nguyenhau442001/Bazan_Humanoid/docs/engineering/evolution_reviews/stagnation_review_gen_188.md

# 🔍 Autonomous Stagnation Audit & Bottleneck Review (Generation #188)

*Generated on 2026-11-11 12:25:54 by the Autonomous Evolution Sentinel.*

---

## 📌 Executive Summary
- **Current Champion Policy:** `v13.5_bidirectional_sprint_champion_rev96`
- **Champion Composite HLI-20 Score:** **65.3 / 100.0**
- **Trigger Event:** 10 consecutive evolutionary generations without score improvement.
- **Failed Canonical Motions:** High-Speed Sprint, Backward Walk, Hurdle Obstacle Clearance, Emergency Brake Stop, 10N Push Shock Recovery

---

## 🛑 Top 5 Identified Pain Points & 25 Candidate Solutions

### Pain Point #1: Heading Stability & Directional Drift (P03_yaw_drift)
**Current Score:** `0.55 / 5.00 pts` | **Focus Category:** *Reward Shaping*

> **Diagnosis:** Torso yaw orientation drifts over extended straight-line strides.

**Candidate Solutions Brainstormed (5 Options):**
- A. Double yaw angular velocity penalty weight in upright posture reward
- B. Integrate projected forward heading error in observation clock
- C. Apply phase-synchronized anti-phase hip yaw counter-torque
- D. Enforce asymmetric foot placement feedback to catch yaw deviations
- E. Add micro-damping to the base yaw DOF in physics contact model

👉 **Selected Actionable Fix:** **A. Double yaw angular velocity penalty weight in upright posture reward (p_straight_yaw: -1.2 -> -2.4)**

---

### Pain Point #2: Action Chatter & Joint Jerk (P05_speed_tracking)
**Current Score:** `0.59 / 5.00 pts` | **Focus Category:** *Action Smoothing*

> **Diagnosis:** High-frequency joint target chatter reduces actuator lifespan and smooth motion.

**Candidate Solutions Brainstormed (5 Options):**
- A. Increase EMA low-pass action filter coefficient from 0.60 to 0.72
- B. Increase action rate delta penalty p_action_rate from -0.08 to -0.15
- C. Introduce second-order action acceleration penalty (a_t - 2*a_t-1 + a_t-2)^2
- D. Add weight decay (L2 regularization 1e-4) to final actor linear layer
- E. Cosine-smooth residual reference targets across phase boundaries

👉 **Selected Actionable Fix:** **A & B. Increase EMA action filter from 0.60 to 0.72 and raise p_action_rate to -0.15**

---

### Pain Point #3: High-Impulse Push Recovery (P15_getup_recovery)
**Current Score:** `1.80 / 5.00 pts` | **Focus Category:** *Domain Randomization*

> **Diagnosis:** Fails 10N violent lateral shove due to narrow stance base.

**Candidate Solutions Brainstormed (5 Options):**
- A. Randomize push disturbances during training with magnitudes up to 8.5 N
- B. Train wide-stance capture-point leg spreading triggered by roll acceleration
- C. Add contact normal force sensory feedback into proprioception observation
- D. Modulate knee stiffness dynamically under sudden ground reaction spikes
- E. Deploy adaptive torso counter-lean impulse reflex

👉 **Selected Actionable Fix:** **A. Calibrate domain randomization push range to 1.5 - 8.5 N with adaptive 4-step impulse duration**

---

### Pain Point #4: Forward Velocity Tracking & Reverse Gait (P12_jerk_smoothness)
**Current Score:** `1.56 / 5.00 pts` | **Focus Category:** *Kinematics & Gait*

> **Diagnosis:** Velocity tracking error on extreme sprint (0.5 m/s) and backward steps.

**Candidate Solutions Brainstormed (5 Options):**
- A. Dynamically modulate step cadence down to 0.26s during sprint commands
- B. Add directional linear velocity tracking bonus scaled with command magnitude
- C. Apply velocity-dependent forward torso pitch angle (+0.16 rad at 0.5 m/s)
- D. Scale hip pitch torque saturation limit during high acceleration phases
- E. Use bidirectional speed curriculum with alternating sprint/reverse intervals

👉 **Selected Actionable Fix:** **C. Amplify velocity-dependent torso pitch lean to 0.16 rad at 0.5 m/s sprint**

---

### Pain Point #5: Foot-Ground Impact Shock & Soft Landing (P14_impact_shock)
**Current Score:** `2.25 / 5.00 pts` | **Focus Category:** *Biomechanical Reward*

> **Diagnosis:** Hard heel strike impacts cause ground rebound and transient attitude jitter.

**Candidate Solutions Brainstormed (5 Options):**
- A. Add soft foot touchdown reward penalizing vertical sole contact velocity
- B. Increase nominal swing ground clearance from 10 mm to 18 mm
- C. Apply ankle compliance damping (proportional ankle pitch back-drive)
- D. Enforce smooth knee flexion right before ground strike (pre-touchdown cushioning)
- E. Add rubber sole contact damping in simulation geometry

👉 **Selected Actionable Fix:** **B & D. Increase swing foot clearance reward to 18 mm and add touchdown impact cushioning penalty**

---

## 🚀 5 Targeted Micro-Improvements Applied for Next Evolutionary Cycle

1. **[Reward Shaping]** Doubled straight-line yaw error penalty ($p_{\text{straight\_yaw}} = -2.40$).
2. **[Action Smoothing]** Raised action filter ($\alpha = 0.72$) and action-rate penalty ($p_{\text{rate}} = -0.15$).
3. **[Domain Randomization]** Calibrated kick disturbance range ($1.5 - 8.5\text{ N}$) with multi-step impulse shock.
4. **[Kinematics & Gait]** Amplified forward pitch lean target to $0.16\text{ rad}$ at $0.5\text{ m/s}$ sprint.
5. **[Biomechanical Reward]** Raised swing clearance target to $18\text{ mm}$ and added touchdown cushioning penalty.

*These 5 micro-improvements are automatically injected into the active training environment configuration.*
