nguyenhau442001/Bazan_Humanoid/software/firmware/stm32f411/Drivers/VERSIONS.md

# Vendored sources

Written by `tools/fetch_drivers.py`; do not edit by hand.

| Source | Tag | Commit |
| --- | --- | --- |
| [STMicroelectronics/stm32f4xx-hal-driver](https://github.com/STMicroelectronics/stm32f4xx-hal-driver) | v1.8.6 | `6ef30cf0ef6cc29ad518f37b9e6de89b6b815f90` |
| [STMicroelectronics/cmsis-device-f4](https://github.com/STMicroelectronics/cmsis-device-f4) | v2.6.9 | `3b64b7b0b546cefe84f13c65508126eea58b97d8` |
| [ARM-software/CMSIS_5](https://github.com/ARM-software/CMSIS_5) | 5.9.0 | `2b7495b8535bdcb306dac29b9ded4cfb679d7e5c` |
| [FreeRTOS/FreeRTOS-Kernel](https://github.com/FreeRTOS/FreeRTOS-Kernel) | V11.1.0 | `dbf70559b27d39c1fdb68dfb9a32140b6a6777a0` |
