nguyenhau442001/Bazan_Humanoid/docs/mechanical/bazan_v4_lap_rap.html

# Bazan v4 · Whole-Robot Assembly Manual

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

tổng thể

## 1. Key Dimensions

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

## 2. Design Rules (Easy Motor and Board Swaps)

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

thân

## 3. Fits and Tolerances (All Parts)

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

## 4. Bill of Materials (Whole Robot)

### 4.1 Servos

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

### 4.2 Screws, Inserts, Bearings, Standoffs (Both Legs Included)

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

### 4.3 Boards and Modules (MEASURE Before Printing Sleds)

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

### 4.4 Printed Parts

Mã | File | Tên | SL | Vật liệu | Khối lượng đặc (g) | Hướng in | Bản vẽ
P0 | L_pelvis_plate | Pelvis Plate (Deck 0) | 1 | PLA | 52.5 | mặt dưới úp xuống bàn; tường pin hướng lên | bản vẽ
P1 | L_deck_1 | Deck 1 | 1 | PLA | 35.0 | phẳng, 2 viền, 15 % infill | bản vẽ
P2 | L_deck_2 | Deck 2 | 1 | PLA | 34.7 | phẳng, 2 viền, 15 % infill | bản vẽ
S1 | L_sled_pca + R_sled_pca | PCA9685 Sled (L/R) | 2 | PLA | 9.6 | đế phẳng xuống bàn, trụ hướng lên | bản vẽ
S2 | L_sled_perf | A+ Board Sled (Black Pill) | 1 | PLA | 19.0 | đế phẳng xuống bàn | bản vẽ
S3 | L_sled_radxa | Radxa Zero 3W Sled | 1 | PLA | 10.7 | đế phẳng xuống bàn | bản vẽ
S4 | L_sled_ubec | UBEC Sled | 1 | PLA | 6.9 | đế phẳng xuống bàn | bản vẽ
S5 | L_sled_buck | 5 V Buck Sled | 1 | PLA | 2.6 | đế phẳng xuống bàn | bản vẽ
S6 | L_sled_ina + R_sled_ina | INA226 Sled (L/R) | 2 | PLA | 2.1 | đế phẳng xuống bàn | bản vẽ
A1 | L_shoulder_mount + R_shoulder_mount | Shoulder Mount (L/R) | 2 | PLA | 9.3 | mặt bích xuống bàn, ổ servo mở lên trên | bản vẽ
A2 | L_shoulder_link + R_shoulder_link | Shoulder Link (L/R) | 2 | PLA | 8.1 | nằm mặt đĩa horn xuống bàn, có support trong ổ | bản vẽ
A3 | L_upper_arm + R_upper_arm | Upper Arm (L/R) | 2 | PLA | 15.0 | nằm nghiêng mặt đĩa horn xuống bàn | bản vẽ
A4 | L_forearm + R_forearm | Forearm and Mitten (L/R) | 2 | PLA | 11.1 | nằm mặt đĩa horn xuống bàn | bản vẽ
N1 | L_neck_mount | Neck Mount | 1 | PLA | 10.1 | mặt bích xuống bàn | bản vẽ
N2 | L_neck_link | Neck Link | 1 | PLA | 7.6 | đĩa horn cổ xuống bàn | bản vẽ
N3 | L_head_frame | Head Frame | 1 | PLA | 19.1 | mặt sàn đầu úp xuống bàn, support dưới 2 đĩa | bản vẽ
N4 | L_cam_mount | Camera + ToF Mount (15° Tilt) | 1 | PLA | 7.0 | đế xuống bàn | bản vẽ
L1 | L_foot + R_foot | Foot | 2 | PLA | 17.0 | xem leg_v3.md | bản vẽ
L2 | L_sole + R_sole | TPU Sole | 2 | TPU 95A | 12.3 | xem leg_v3.md | bản vẽ
L3 | L_ankle_block + R_ankle_block | Ankle Block | 2 | PLA | 12.3 | xem leg_v3.md | bản vẽ
L4 | L_shin + R_shin | Shin | 2 | PLA | 10.1 | xem leg_v3.md | bản vẽ
L5 | L_thigh + R_thigh | Thigh | 2 | PLA | 18.1 | xem leg_v3.md | bản vẽ
L6 | L_hip_block + R_hip_block | Hip Block | 2 | PLA | 12.3 | xem leg_v3.md | bản vẽ
L7 | L_yaw_bracket + R_yaw_bracket | Yaw Bracket | 2 | PLA | 14.8 | xem leg_v3.md | bản vẽ
L8 | L_thrust_ring + R_thrust_ring | Thrust Ring | 2 | PLA | 4.8 | xem leg_v3.md | bản vẽ
L9 | L_hip_mount + R_hip_mount | Hip Mount | 2 | PLA | 12.9 | xem leg_v3.md | bản vẽ

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

## 5. Preparation (Step 0)

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

## 6. Assembly

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

### Step 1. Leg 1: Foot + TPU Sole

leg_01

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

### Step 2. Leg 2: Ankle Block

leg_02

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

### Step 3. Leg 3: Shin

leg_03

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

### Step 4. Leg 4: Thigh

leg_04

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

### Step 5. Leg 5: Hip Block

leg_05

Khối hông (L6) mang hip roll và hip pitch. Đùi lên trục hip pitch (chân thẳng).

### Step 6. Leg 6: Yaw Bracket

leg_06

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

### Step 7. Leg 7: Thrust Ring + Hip Mount

leg_07

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

### Step 8. Torso 1: Heat-Set Inserts in Pelvis Plate P0

torso_01

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

### Step 9. Torso 2: Mount Both Leg Modules to P0

torso_02

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

### Step 10. Torso 3: Four SO40 Standoffs

torso_03

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

### Step 11. Torso 4: Two PCA9685 Boards on Sleds S1

torso_04

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

### Step 12. Torso 5: 2S Battery

torso_05

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

### Step 13. Torso 6: Deck 1 on the Bench

torso_06

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

### Step 14. Torso 7: Deck 1 onto Standoffs, Four SO35

torso_07

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

### Step 15. Torso 8: Deck 2 and Radxa

torso_08

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

### Step 16. Head 1: Neck Mount N1 and Neck Yaw Servo

head_01

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

### Step 17. Head 2: Neck Link N2 and Head Pitch Servo

head_02

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

### Step 18. Head 3: Head Frame N3, Camera Mount N4, Display

head_03

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

### Step 19. Arm 1: Shoulder Mount A1 and Shoulder Pitch Servo

arm_01

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

### Step 20. Arm 2: Arm Sub-Assembly on the Bench

arm_02

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

### Step 21. Arm 3: Arm onto the Shoulder

arm_03

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

## 7. Hole Tables: Torso, Arms, Head

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

#### N4 · cam_mount — Camera + ToF Mount (15° Tilt)

Điểm tham chiếu: mặt sàn đầu, tâm bay camera = robot (+12.0, +0.0, +230.5).

cam_mount

# | Lỗ | Loại | Ø | Sâu | Vị trí (x, y, z) | Hướng | Dùng cho

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

#### P1 · deck_1 — Deck 1

Điểm tham chiếu: tâm robot trên mặt trên tầng = robot (+0.0, +0.0, +120.5).

deck_1

# | Lỗ | Loại | Ø | Sâu | Vị trí (x, y, z) | Hướng | Dùng cho

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

#### P2 · deck_2 — Deck 2

Điểm tham chiếu: tâm robot trên mặt trên tầng = robot (+0.0, +0.0, +158.5).

deck_2

# | Lỗ | Loại | Ø | Sâu | Vị trí (x, y, z) | Hướng | Dùng cho

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

#### A4 · forearm — Forearm and Mitten (L/R)

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

forearm

# | Lỗ | Loại | Ø | Sâu | Vị trí (x, y, z) | Hướng | Dùng cho

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

#### N3 · head_frame — Head Frame

Điểm tham chiếu: tâm trục gật đầu (giữa ổ) = robot (-3.0, +0.0, +207.5).

head_frame

# | Lỗ | Loại | Ø | Sâu | Vị trí (x, y, z) | Hướng | Dùng cho

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

#### N2 · neck_link — Neck Link

Điểm tham chiếu: tâm trục gật đầu (giữa ổ) = robot (-3.0, +0.0, +207.5).

neck_link

# | Lỗ | Loại | Ø | Sâu | Vị trí (x, y, z) | Hướng | Dùng cho

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

#### N1 · neck_mount — Neck Mount

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

neck_mount

# | Lỗ | Loại | Ø | Sâu | Vị trí (x, y, z) | Hướng | Dùng cho

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

#### P0 · pelvis_plate — Pelvis Plate (Deck 0)

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

pelvis_plate

# | Lỗ | Loại | Ø | Sâu | Vị trí (x, y, z) | Hướng | Dùng cho

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

#### A2 · shoulder_link — Shoulder Link (L/R)

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

shoulder_link

# | Lỗ | Loại | Ø | Sâu | Vị trí (x, y, z) | Hướng | Dùng cho

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

#### A1 · shoulder_mount — Shoulder Mount (L/R)

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

shoulder_mount

# | Lỗ | Loại | Ø | Sâu | Vị trí (x, y, z) | Hướng | Dùng cho

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

#### S5 · sled_buck — 5 V Buck Sled

Điểm tham chiếu: tâm bay trên mặt deck 1 = robot (-27.0, -23.5, +120.5).

sled_buck

# | Lỗ | Loại | Ø | Sâu | Vị trí (x, y, z) | Hướng | Dùng cho

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

#### S6 · sled_ina — INA226 Sled (L/R)

Điểm tham chiếu: tâm bay trên mặt deck 1 = robot (+8.0, +45.5, +120.5).

sled_ina

# | Lỗ | Loại | Ø | Sâu | Vị trí (x, y, z) | Hướng | Dùng cho

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

#### S1 · sled_pca — PCA9685 Sled (L/R)

Điểm tham chiếu: tâm bay trên mặt deck 0 = robot (-3.5, +36.5, +77.5).

sled_pca

# | Lỗ | Loại | Ø | Sâu | Vị trí (x, y, z) | Hướng | Dùng cho

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

#### S2 · sled_perf — A+ Board Sled (Black Pill)

Điểm tham chiếu: tâm bay trên mặt deck 1 = robot (+13.0, +0.0, +120.5).

sled_perf

# | Lỗ | Loại | Ø | Sâu | Vị trí (x, y, z) | Hướng | Dùng cho

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

#### S3 · sled_radxa — Radxa Zero 3W Sled

Điểm tham chiếu: tâm bay trên mặt deck 2 = robot (+24.5, +0.0, +158.5).

sled_radxa

# | Lỗ | Loại | Ø | Sâu | Vị trí (x, y, z) | Hướng | Dùng cho

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

#### S4 · sled_ubec — UBEC Sled

Điểm tham chiếu: tâm bay trên mặt deck 1 = robot (-29.5, +12.5, +120.5).

sled_ubec

# | Lỗ | Loại | Ø | Sâu | Vị trí (x, y, z) | Hướng | Dùng cho

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

#### A3 · upper_arm — Upper Arm (L/R)

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

upper_arm

# | Lỗ | Loại | Ø | Sâu | Vị trí (x, y, z) | Hướng | Dùng cho

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

## 8. Cable Routing

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

## 9. Replacing One Servo

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

## 10. CAD Checks Run

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

• check.py: chân như leg_v3 (va chạm, rút servo, dụng cụ, 2 chân cạnh nhau).

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

## 11. Open Items

1. Mọi kích thước MEASURE (servo, horn, module) — đo trước khi in.

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
