nguyenhau442001/Bazan_Humanoid/design/blender/tables/links_mass.csv

link | mass_g | old_mass_g | com_x_mm | com_y_mm | com_z_mm | Ixx | Iyy | Izz | Ixy | Ixz | Iyz (g.mm^2, about link CoM)
base_link | 243.0 | 216.8 | -1.2 | -0.0 | 65.6 | 245159 | 178253 | 123761 | -0 | 2315 | -0
neck_yaw_link | 12.8 | 13.0 | 0.0 | -0.0 | 17.1 | 2190 | 1852 | 912 | -0 | 0 | -0
head_pitch_link | 65.1 | 20.0 | 9.3 | 0.2 | 25.0 | 55191 | 47355 | 60099 | -225 | -1853 | -241
l_shoulder_pitch_link | 7.4 | 1.0 | -0.0 | 6.4 | -1.6 | 1660 | 1421 | 1655 | 0 | -0 | 19
l_shoulder_roll_link | 13.2 | 12.0 | -0.0 | 0.0 | -9.8 | 2713 | 2194 | 1093 | -0 | -0 | 0
l_elbow_link | 17.0 | 12.5 | 0.1 | -0.0 | -7.1 | 4995 | 5285 | 1175 | 3 | 49 | -14
r_shoulder_pitch_link | 7.4 | 1.0 | -0.0 | -6.4 | -1.6 | 1660 | 1421 | 1655 | 0 | -0 | -19
r_shoulder_roll_link | 13.2 | 12.0 | -0.0 | 0.0 | -9.8 | 2713 | 2194 | 1093 | 0 | -0 | -0
r_elbow_link | 17.0 | 12.5 | 0.1 | 0.0 | -7.1 | 4995 | 5285 | 1175 | -3 | 49 | 14
l_hip_roll_link | 21.0 | 14.0 | -9.3 | 0.0 | -0.8 | 2708 | 3223 | 2564 | -0 | 150 | 0
l_hip_pitch_link | 21.9 | 25.0 | 0.0 | -0.0 | -11.1 | 3905 | 4386 | 1760 | 0 | 0 | -0
l_knee_link | 24.0 | 25.0 | -0.0 | -0.0 | -4.1 | 4645 | 5121 | 1903 | -0 | 0 | -0
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
