nguyenhau442001/Bazan_Humanoid/design/blender/renders/back.png

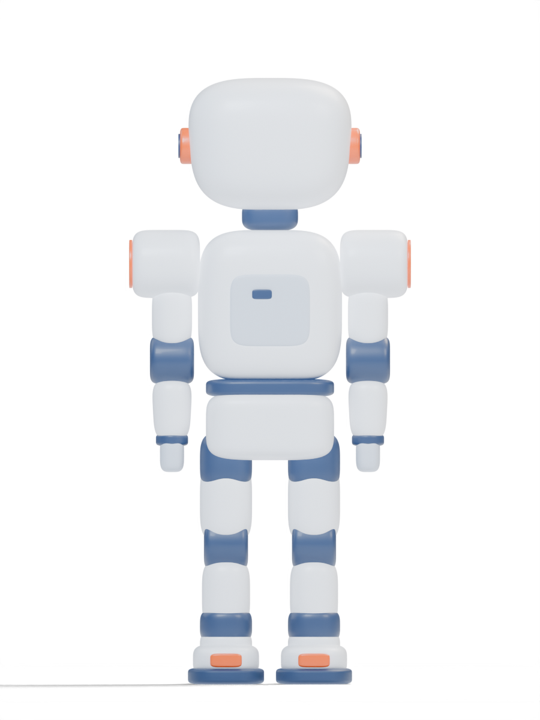
design/blender/renders/back.png
