nguyenhau442001/Bazan_Humanoid/design/blender/renders/detail_arm.png

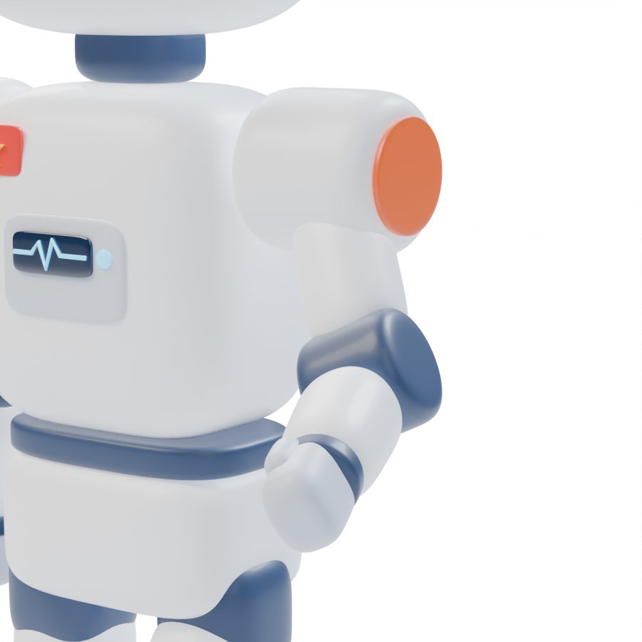
design/blender/renders/detail_arm.png
