nguyenhau442001/Bazan_Humanoid/design/blender/renders/detail_foot.png

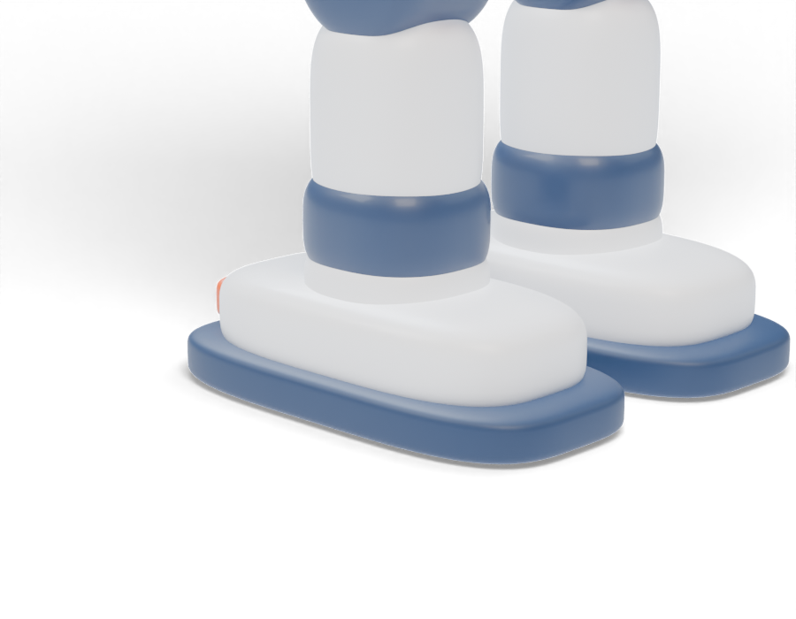
design/blender/renders/detail_foot.png
