nguyenhau442001/Bazan_Humanoid/design/blender/renders/detail_leg.png

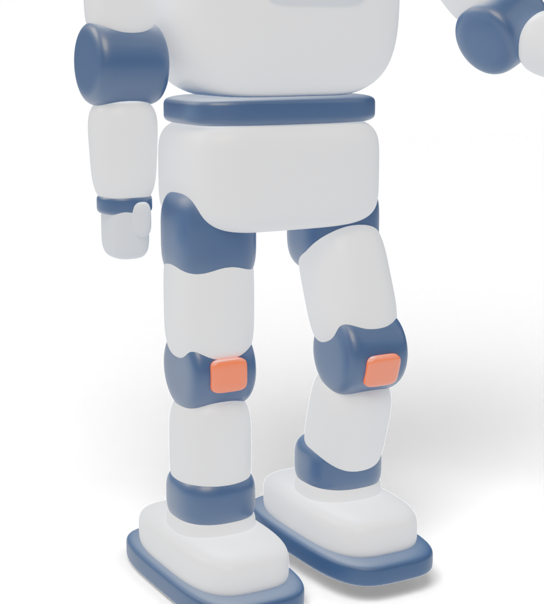
design/blender/renders/detail_leg.png
