nguyenhau442001/Bazan_Humanoid/design/blender/renders/face_curious.png

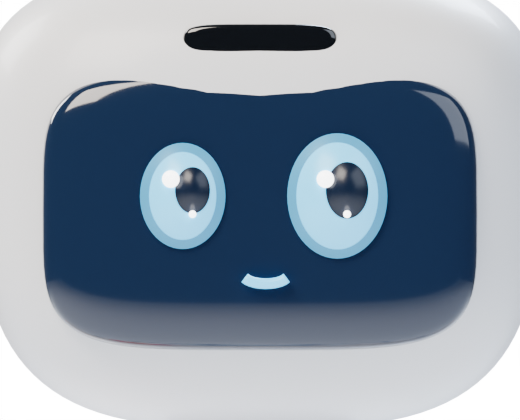
design/blender/renders/face_curious.png
