nguyenhau442001/Bazan_Humanoid/design/blender/renders/face_happy.png

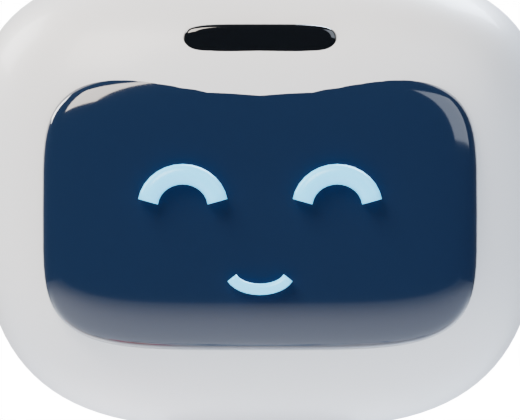
design/blender/renders/face_happy.png
