nguyenhau442001/Bazan_Humanoid/design/blender/renders/face_sleepy.png

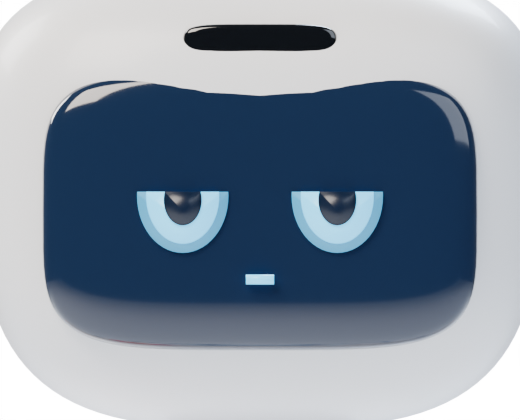
design/blender/renders/face_sleepy.png
