nguyenhau442001/Bazan_Humanoid/design/blender/renders/head.png

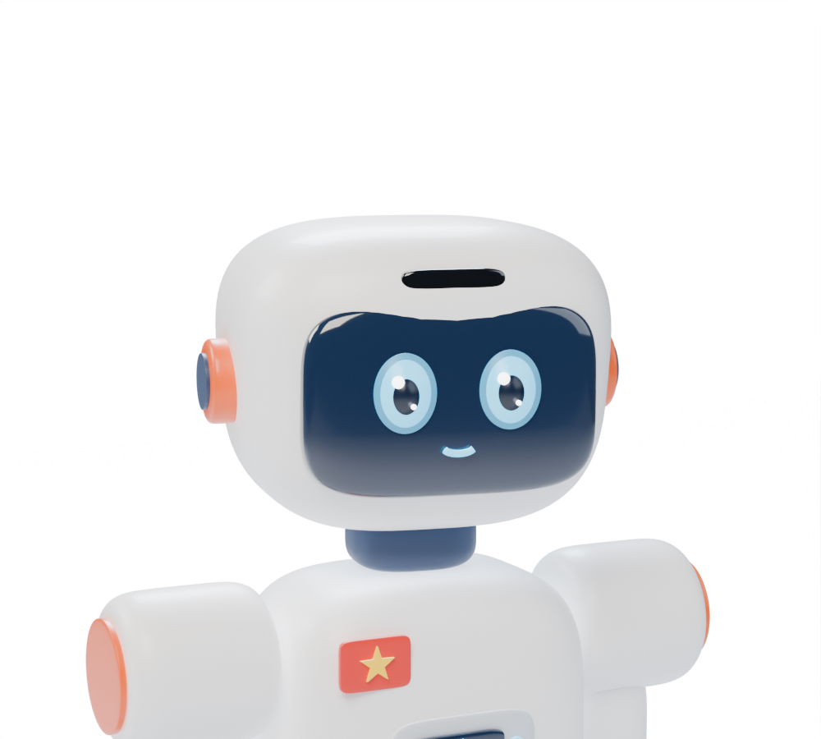
design/blender/renders/head.png
