nguyenhau442001/Bazan_Humanoid/design/blender/renders/hero.png

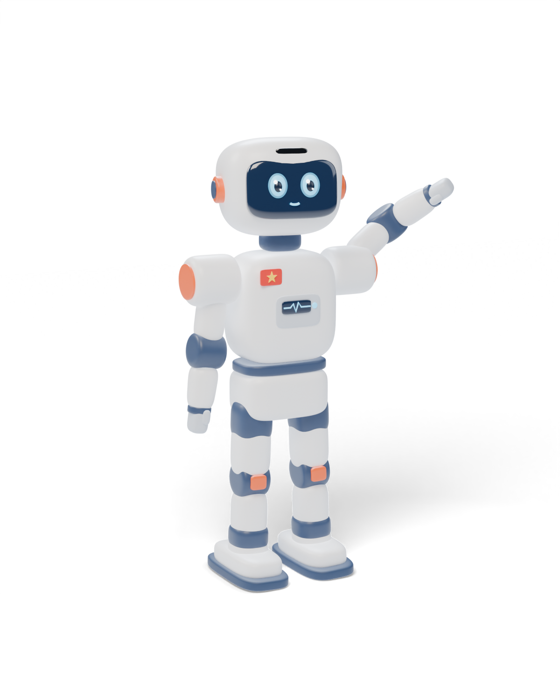
design/blender/renders/hero.png
