nguyenhau442001/Bazan_Humanoid/design/blender/renders/side.png

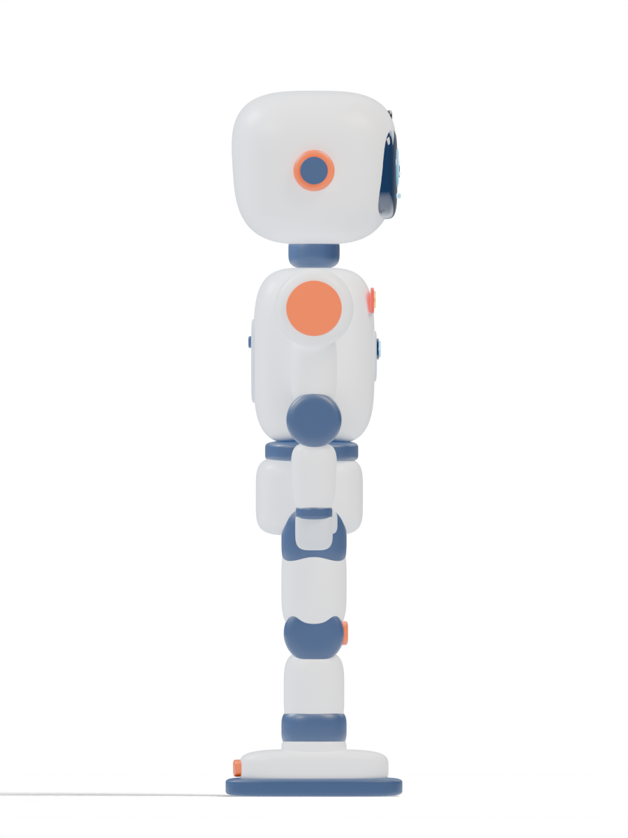
design/blender/renders/side.png
