nguyenhau442001/Bazan_Humanoid/design/blender/renders/xray.png

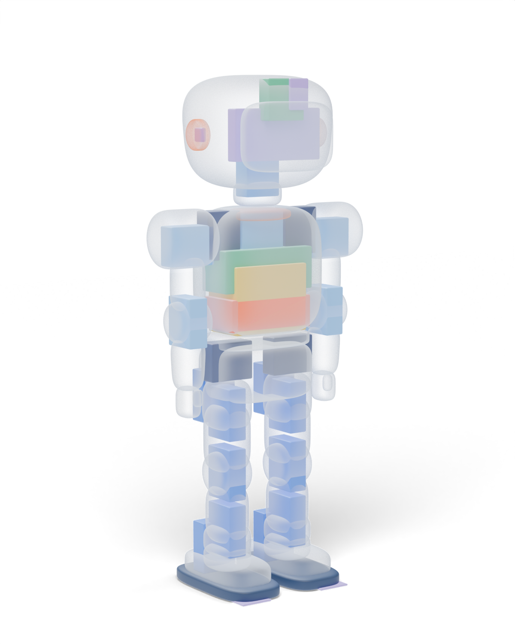
design/blender/renders/xray.png
