nguyenhau442001/Bazan_Humanoid/docs/images/bazan_fpv_walk.gif

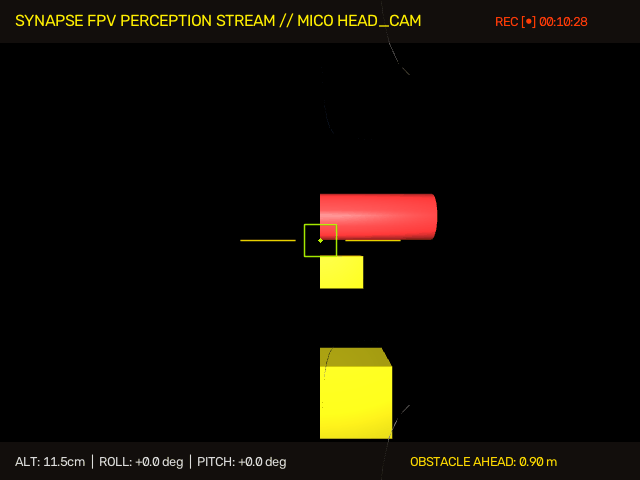
docs/images/bazan_fpv_walk.gif
