nguyenhau442001/Bazan_Humanoid/docs/images/bazan_pip_walk.gif

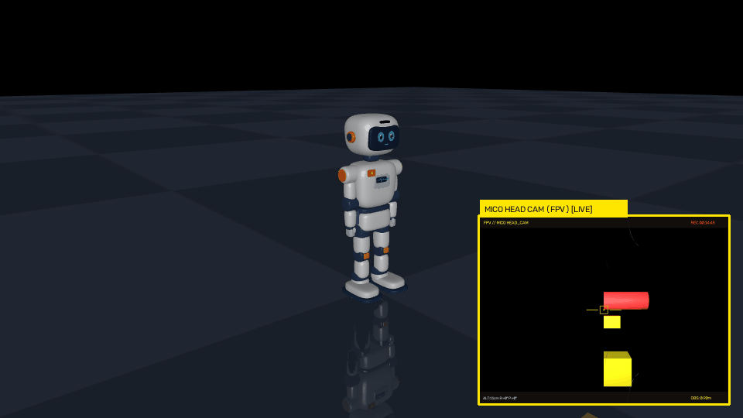
docs/images/bazan_pip_walk.gif
