nguyenhau442001/Bazan_Humanoid/docs/images/evolution/comparison_latest.gif

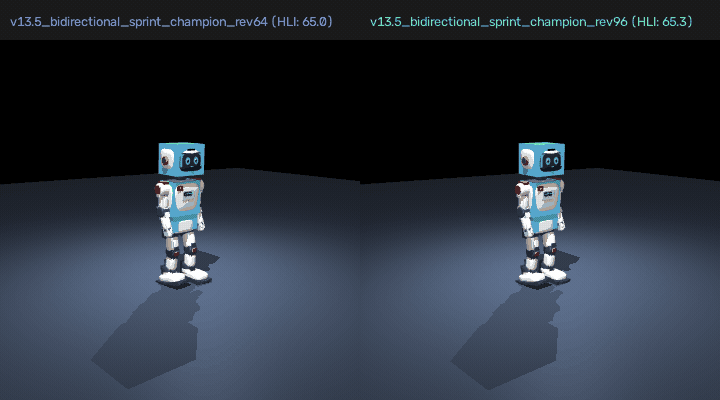
docs/images/evolution/comparison_latest.gif
