nguyenhau442001/Bazan_Humanoid/docs/images/evolution/comparison_latest.png

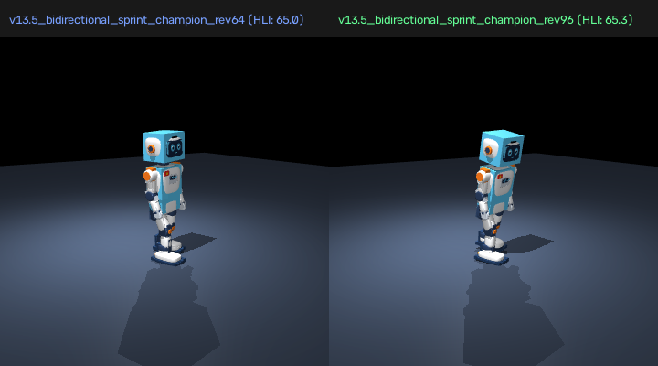
docs/images/evolution/comparison_latest.png
