nguyenhau442001/Bazan_Humanoid/docs/images/evolution/comparison_stage_1_v10.1_straight_walk.png

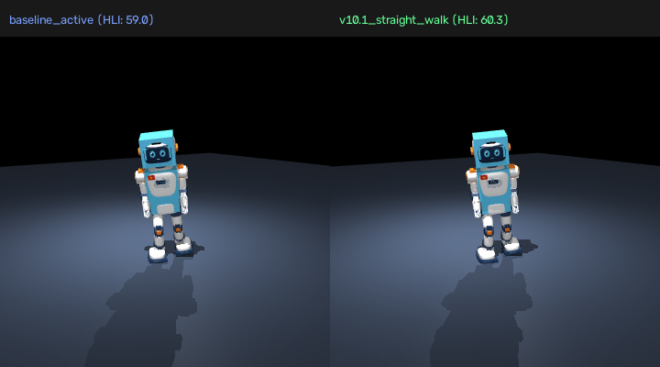
docs/images/evolution/comparison_stage_1_v10.1_straight_walk.png
