nguyenhau442001/Bazan_Humanoid/docs/images/evolution/comparison_stage_1_v13.5_bidirectional_sprint_champion_rev3.png

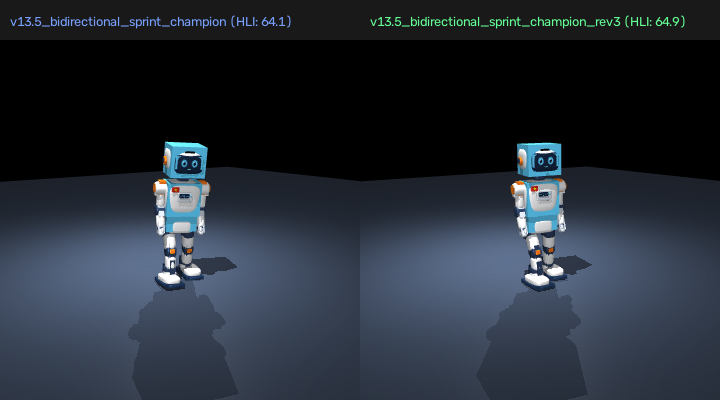
docs/images/evolution/comparison_stage_1_v13.5_bidirectional_sprint_champion_rev3.png
