nguyenhau442001/Bazan_Humanoid/docs/images/mico_fpv_sequence.png

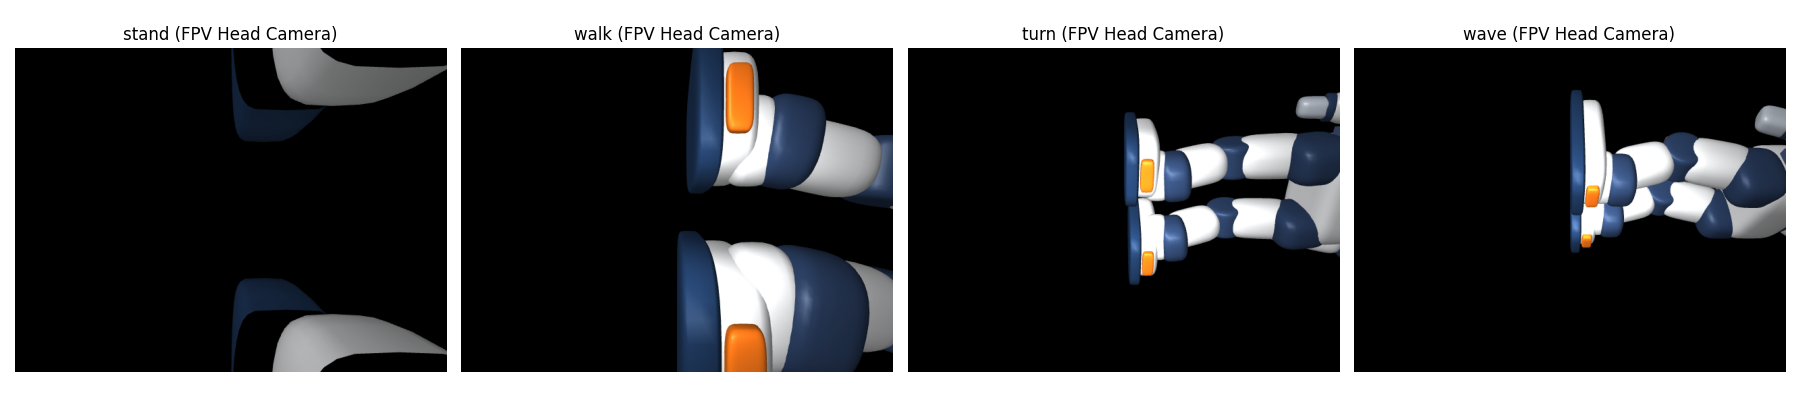
docs/images/mico_fpv_sequence.png
