nguyenhau442001/Bazan_Humanoid/docs/images/platform_architecture_5layers.png

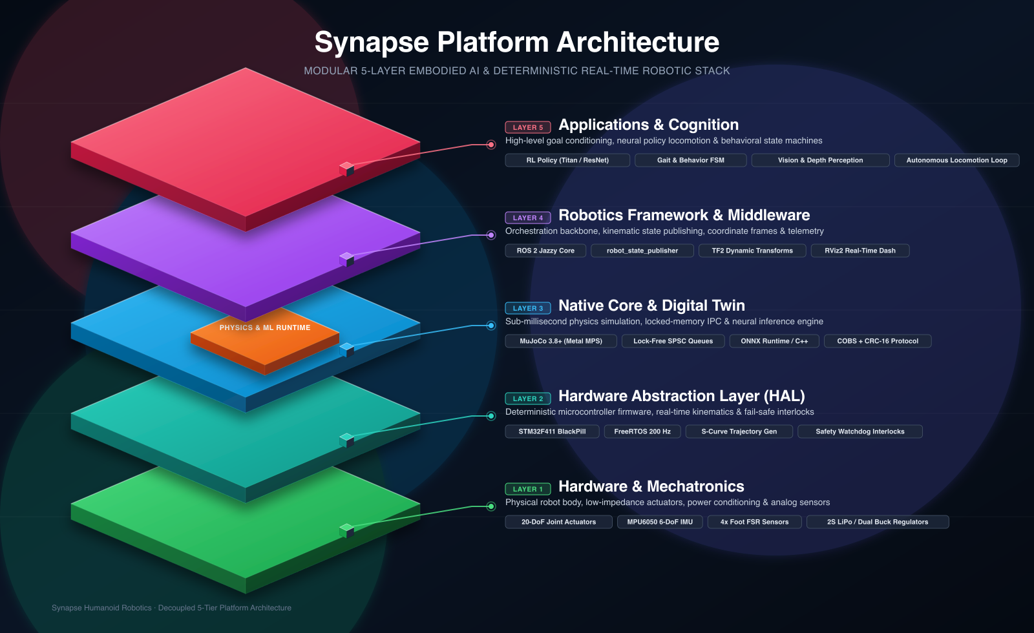
docs/images/platform_architecture_5layers.png
