nguyenhau442001/Bazan_Humanoid/docs/mechanical/images/leg_crouch.jpg

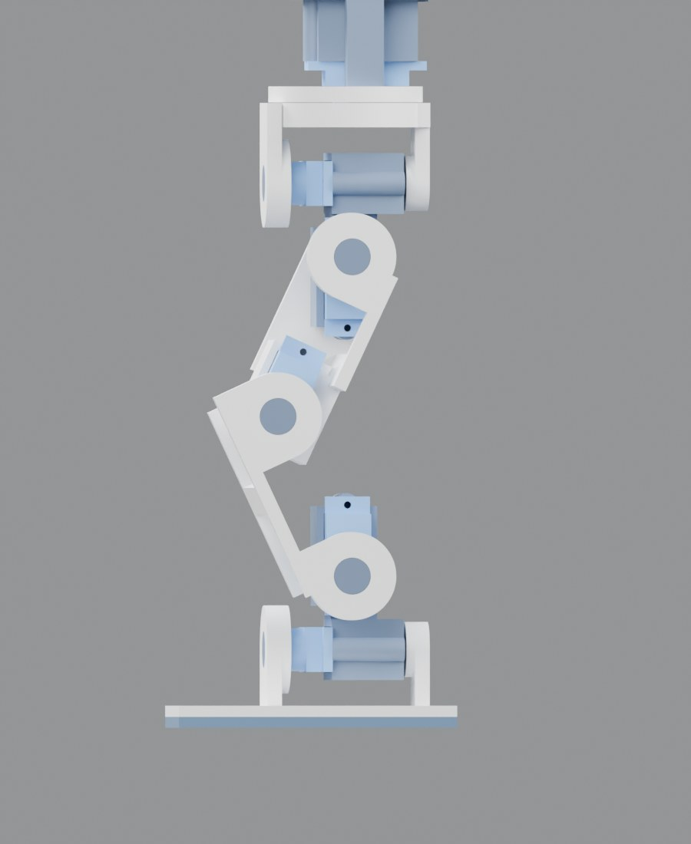
docs/mechanical/images/leg_crouch.jpg
