nguyenhau442001/Bazan_Humanoid/docs/mechanical/images/leg_side.jpg

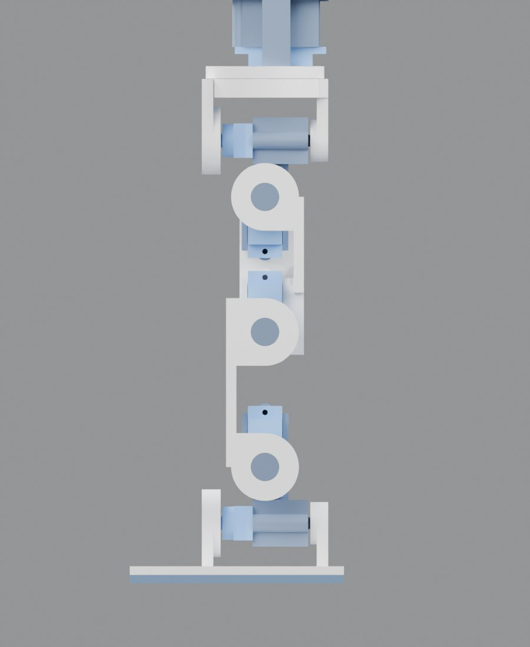
docs/mechanical/images/leg_side.jpg
