nguyenhau442001/Bazan_Humanoid/docs/mechanical/v4/steps/overview_back.png

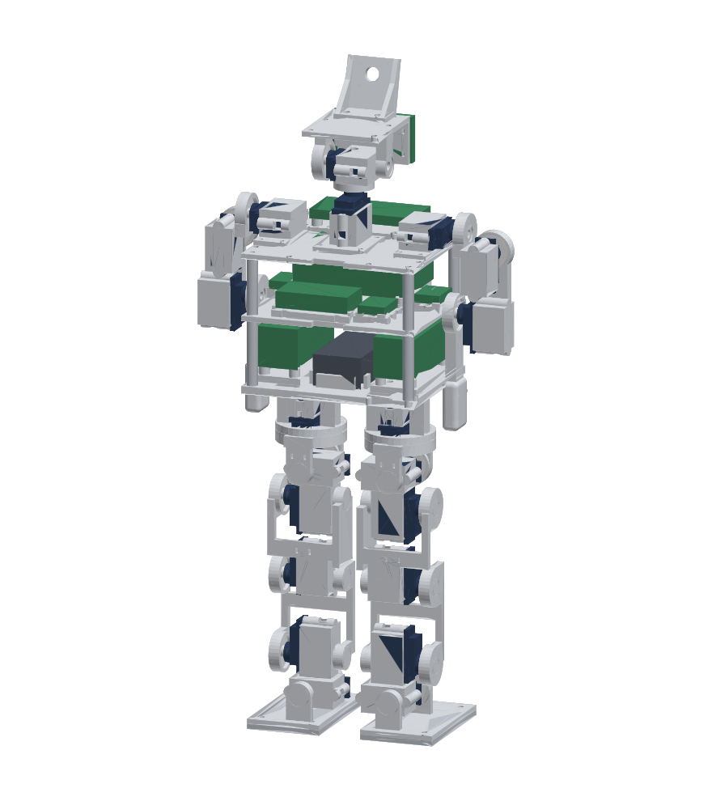
docs/mechanical/v4/steps/overview_back.png
