nguyenhau442001/Bazan_Humanoid/software/ros2/src/humanoid_description/meshes/visual/bazan/r_shoulder_pitch__white.stl

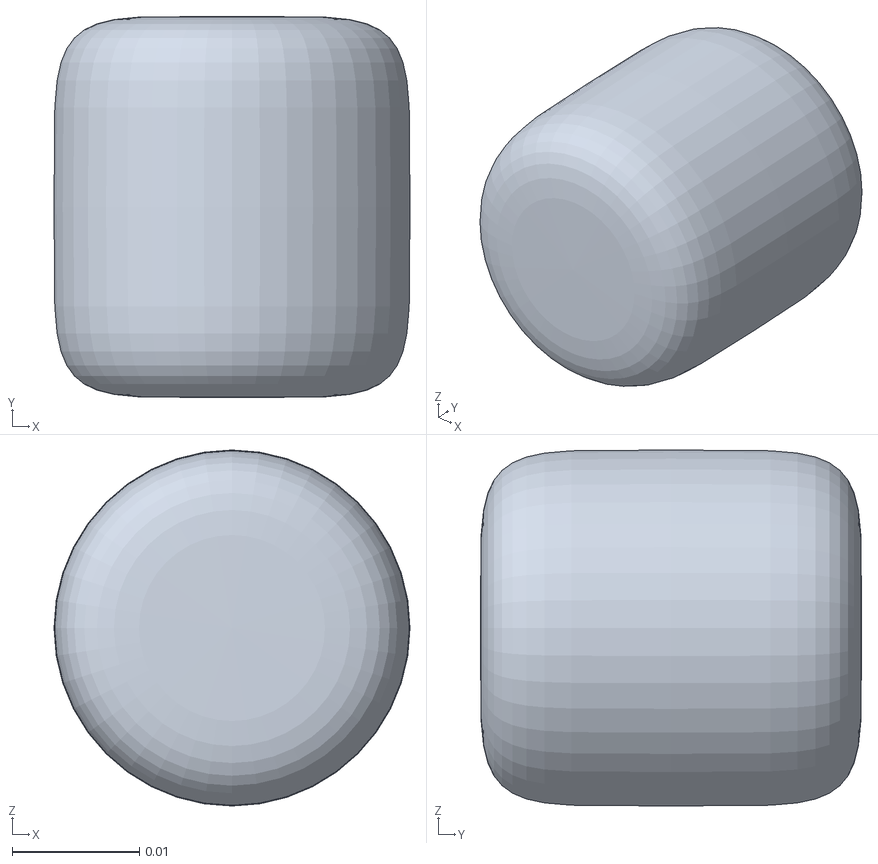
[picture p105: CAD file, 2026-11-10]
software/ros2/src/humanoid_description/meshes/visual/bazan/r_shoulder_pitch__white.stl
0.028 x 0.03 x 0.028
