nguyenhau442001/Bazan_Humanoid/software/ros2/src/humanoid_description/meshes/visual/bazan/r_knee__joint.stl

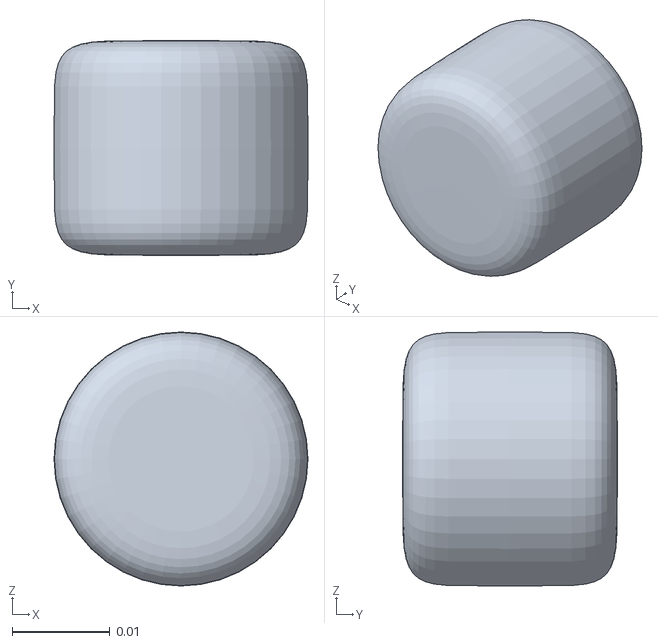
[picture p106: CAD file, 2026-11-10]
software/ros2/src/humanoid_description/meshes/visual/bazan/r_knee__joint.stl
0.026 x 0.022 x 0.026
