nguyenhau442001/Bazan_Humanoid/software/ros2/src/humanoid_description/meshes/visual/bazan/r_shoulder_roll__white.stl

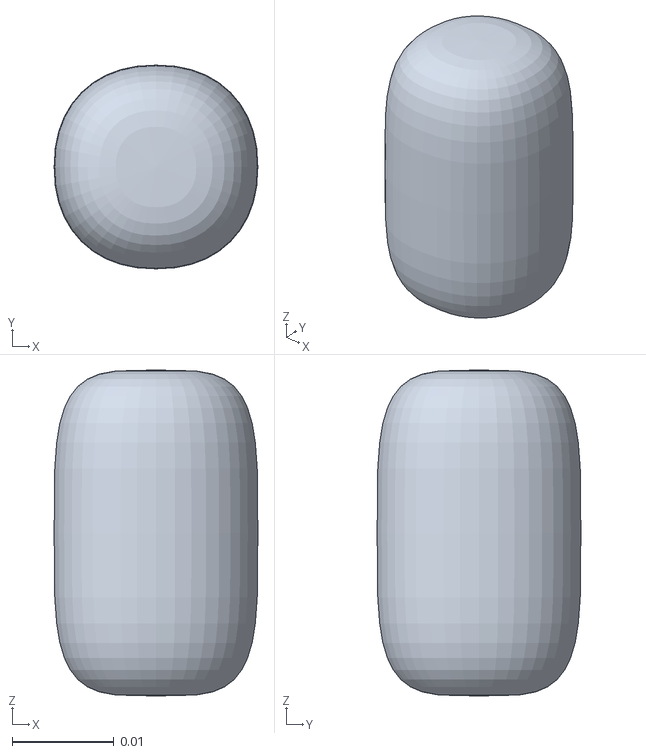
[picture p107: CAD file, 2026-11-10]
software/ros2/src/humanoid_description/meshes/visual/bazan/r_shoulder_roll__white.stl
0.02 x 0.02 x 0.032
