nguyenhau442001/Bazan_Humanoid/software/ros2/src/humanoid_description/meshes/visual/bazan/l_hip_pitch__white.stl

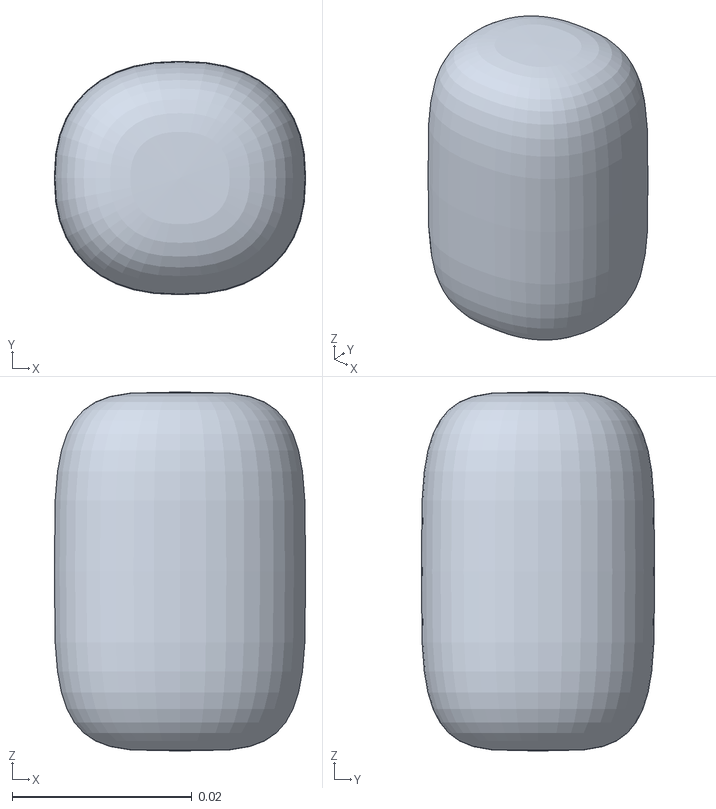
[picture p108: CAD file, 2026-11-10]
software/ros2/src/humanoid_description/meshes/visual/bazan/l_hip_pitch__white.stl
0.028 x 0.026 x 0.04
