nguyenhau442001/Bazan_Humanoid/software/ros2/src/humanoid_description/meshes/visual/bazan/l_knee__orange.stl

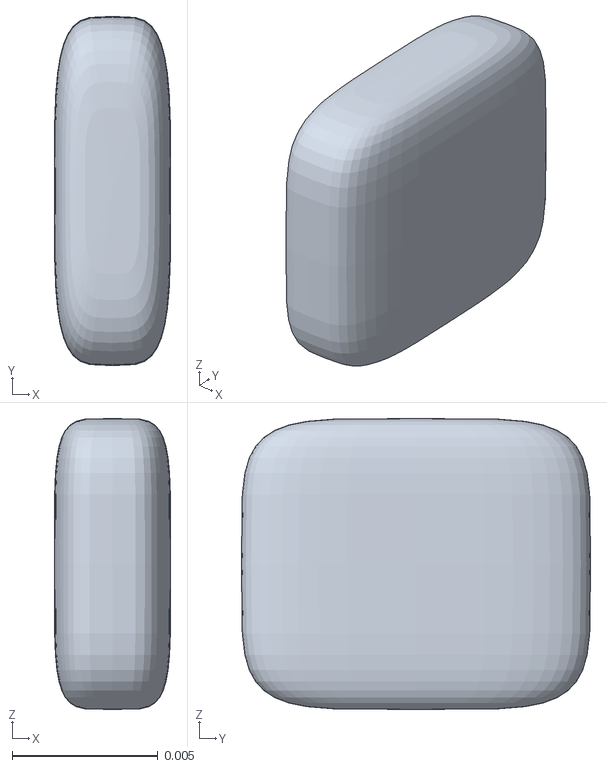
[picture p109: CAD file, 2026-11-10]
software/ros2/src/humanoid_description/meshes/visual/bazan/l_knee__orange.stl
0.004 x 0.012 x 0.01
