nguyenhau442001/Bazan_Humanoid/software/ros2/src/humanoid_description/meshes/visual/bazan/neck_yaw__joint.stl

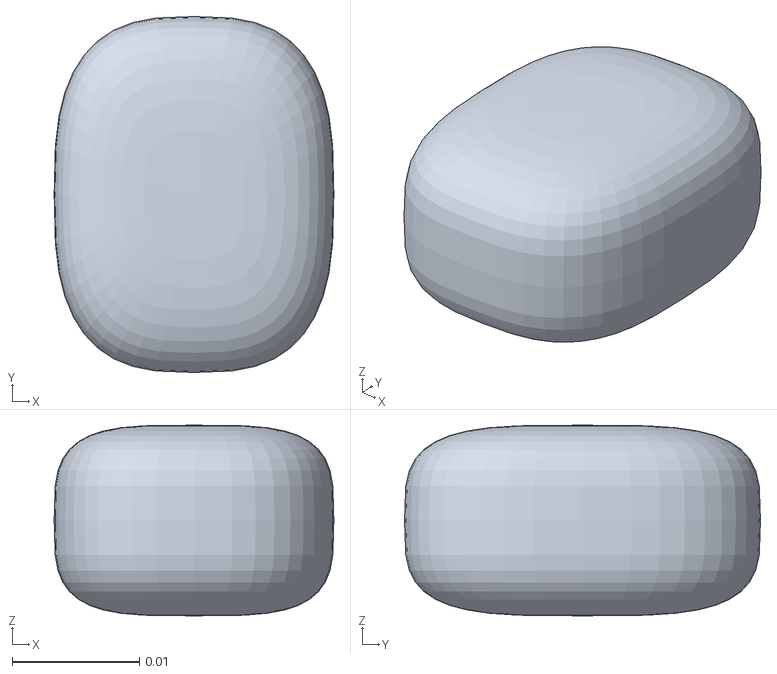
[picture p111: CAD file, 2026-11-10]
software/ros2/src/humanoid_description/meshes/visual/bazan/neck_yaw__joint.stl
0.022 x 0.028 x 0.015
