nguyenhau442001/Bazan_Humanoid/software/ros2/src/humanoid_description/meshes/visual/bazan/r_hip_roll__joint.stl

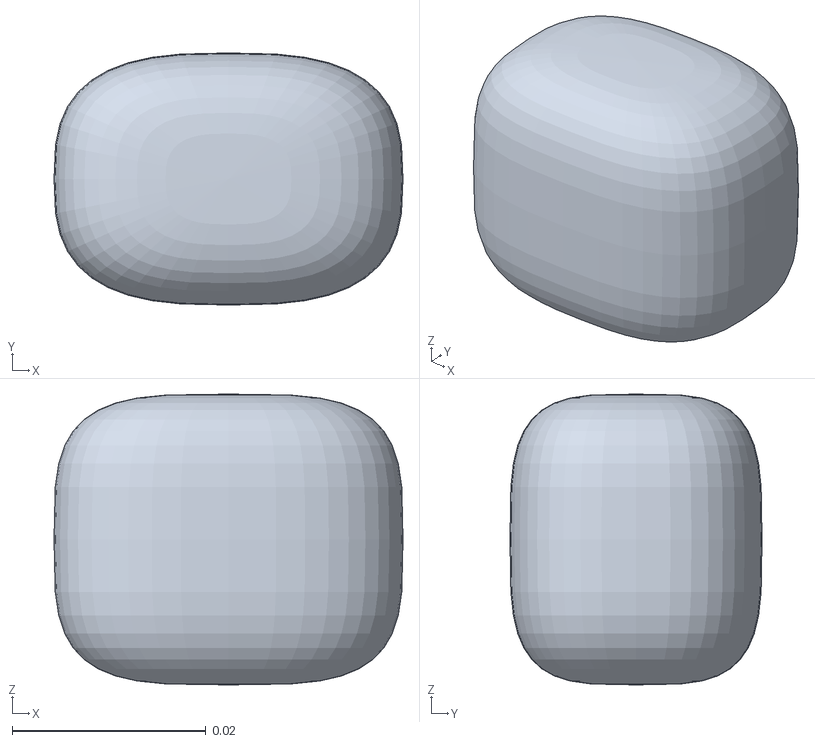
[picture p112: CAD file, 2026-11-10]
software/ros2/src/humanoid_description/meshes/visual/bazan/r_hip_roll__joint.stl
0.036 x 0.026 x 0.03
