nguyenhau442001/Bazan_Humanoid/software/ros2/src/humanoid_description/meshes/visual/bazan/r_knee__white.stl

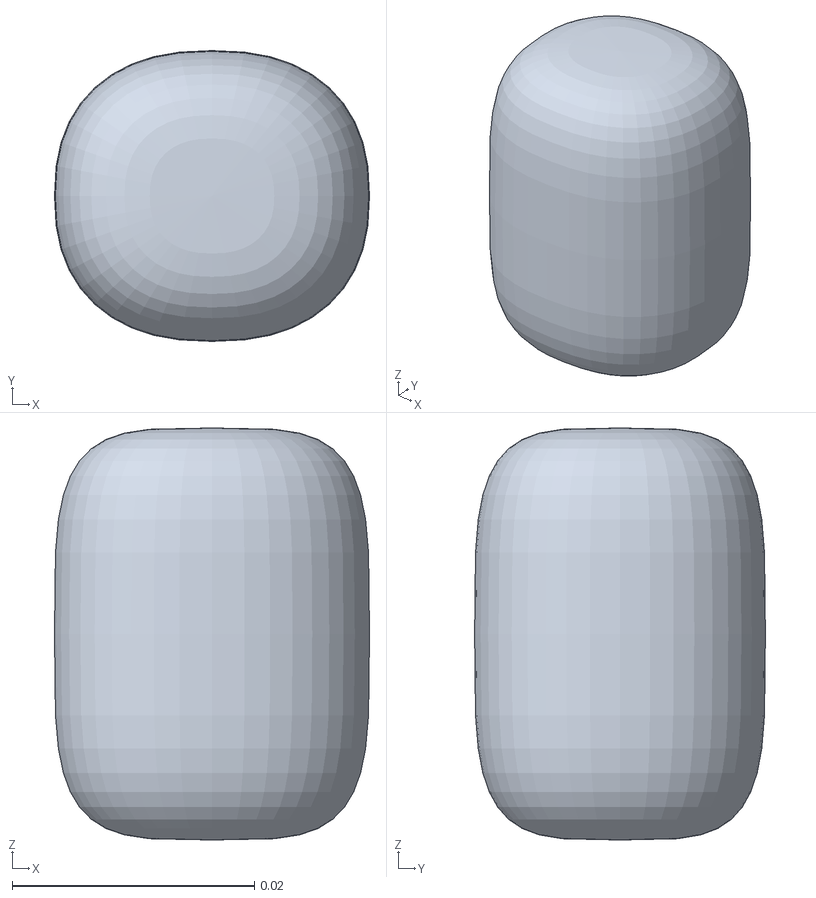
[picture p113: CAD file, 2026-11-10]
software/ros2/src/humanoid_description/meshes/visual/bazan/r_knee__white.stl
0.026 x 0.024 x 0.034
