nguyenhau442001/Bazan_Humanoid/software/ros2/src/humanoid_description/meshes/visual/bazan/r_elbow__grey.stl

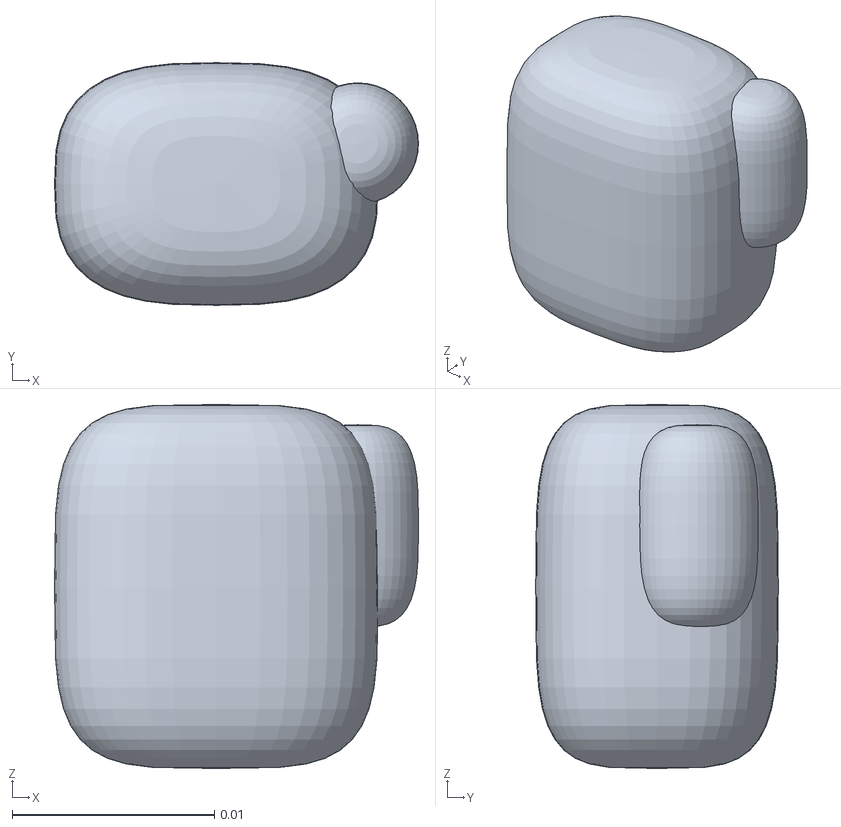
[picture p114: CAD file, 2026-11-10]
software/ros2/src/humanoid_description/meshes/visual/bazan/r_elbow__grey.stl
0.018 x 0.012 x 0.018
