nguyenhau442001/Bazan_Humanoid/software/ros2/src/humanoid_description/meshes/visual/bazan/head_pitch__eye_glow.stl

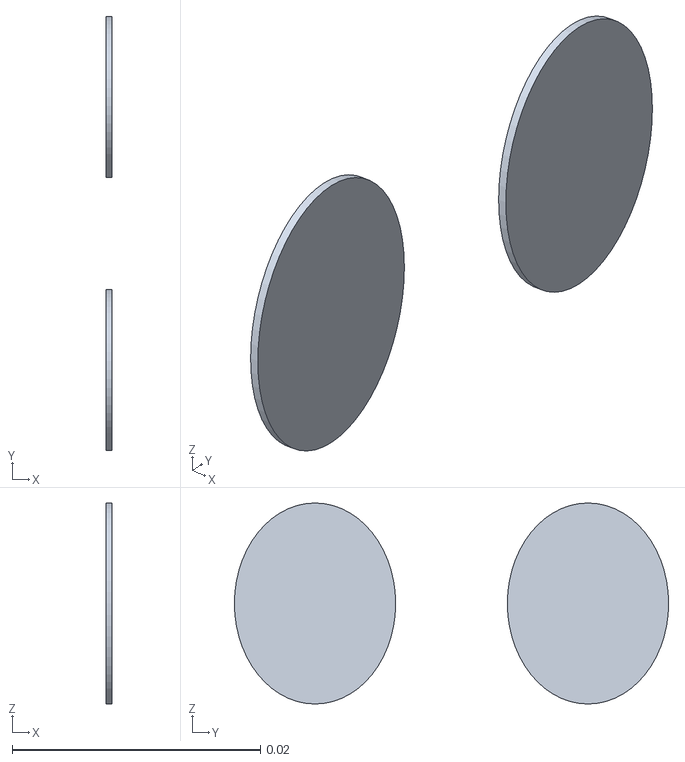
[picture p115: CAD file, 2026-11-10]
software/ros2/src/humanoid_description/meshes/visual/bazan/head_pitch__eye_glow.stl
0.0005 x 0.035 x 0.0162
