nguyenhau442001/Bazan_Humanoid/software/ros2/src/humanoid_description/meshes/visual/bazan/r_ankle_roll__orange.stl

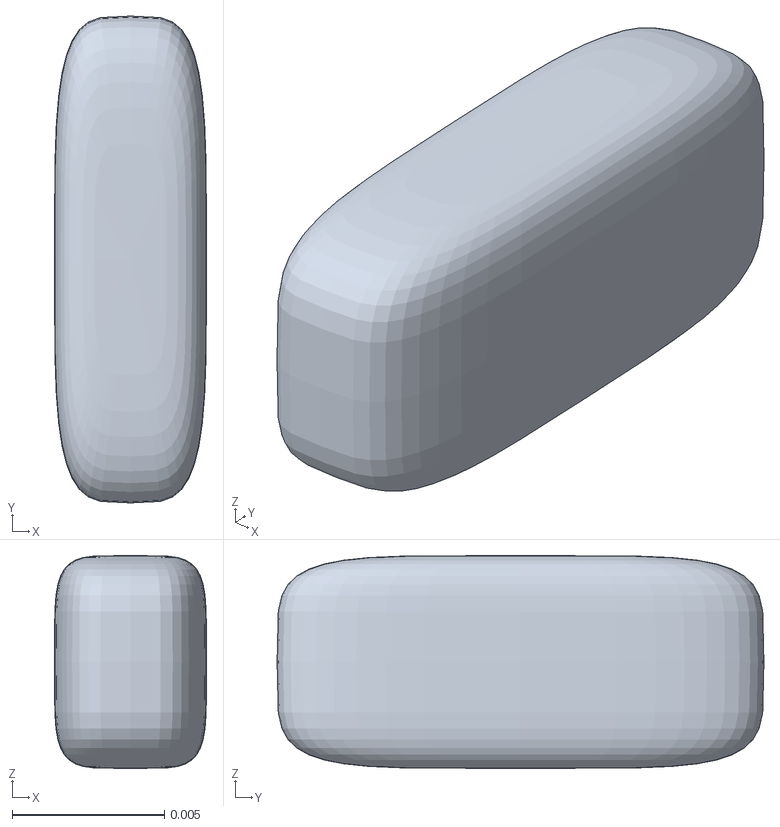
[picture p116: CAD file, 2026-11-10]
software/ros2/src/humanoid_description/meshes/visual/bazan/r_ankle_roll__orange.stl
0.005 x 0.016 x 0.007
