nguyenhau442001/Bazan_Humanoid/software/ros2/src/humanoid_description/meshes/visual/bazan/base__yellow.stl

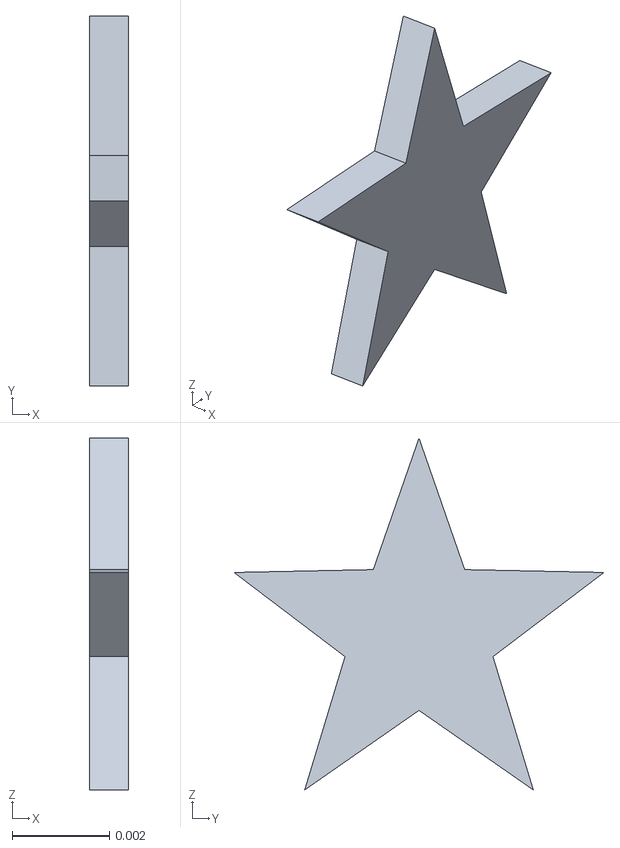
[picture p117: CAD file, 2026-11-10]
software/ros2/src/humanoid_description/meshes/visual/bazan/base__yellow.stl
0.0008 x 0.00761 x 0.00724
