nguyenhau442001/Bazan_Humanoid/software/ros2/src/humanoid_description/meshes/visual/bazan/head_pitch__glint.stl

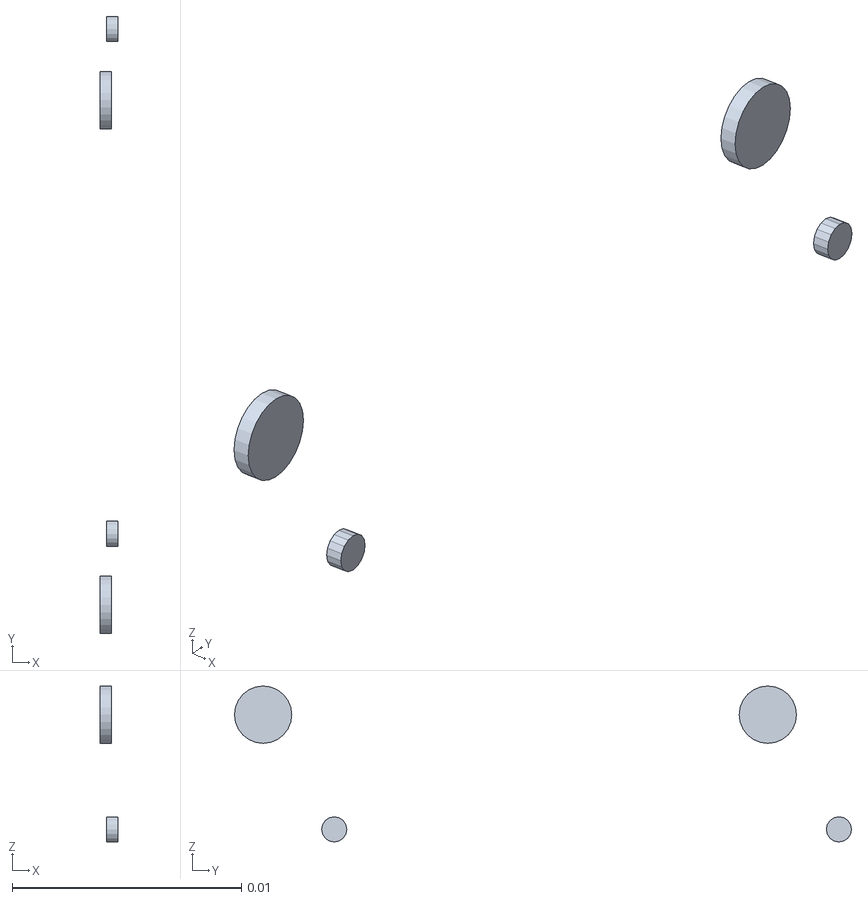
[picture p118: CAD file, 2026-11-10]
software/ros2/src/humanoid_description/meshes/visual/bazan/head_pitch__glint.stl
0.0008 x 0.0269 x 0.0068
