nguyenhau442001/Bazan_Humanoid/software/ros2/src/humanoid_description/meshes/visual/bazan/head_pitch__white.stl

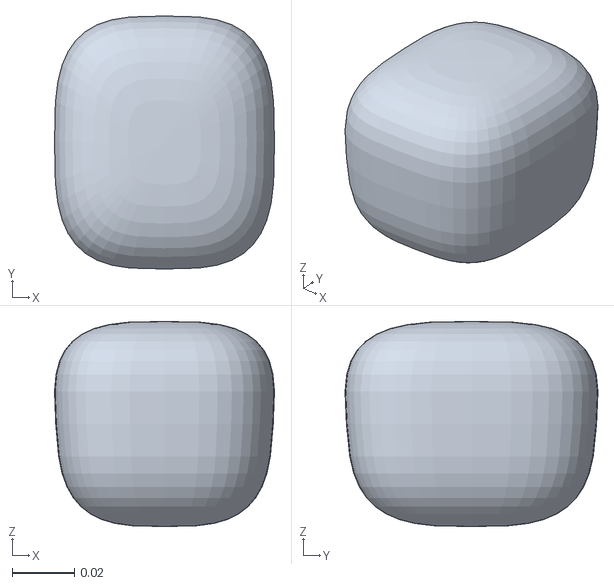
[picture p119: CAD file, 2026-11-10]
software/ros2/src/humanoid_description/meshes/visual/bazan/head_pitch__white.stl
0.0708 x 0.0814 x 0.066
