nguyenhau442001/Bazan_Humanoid/software/ros2/src/humanoid_description/meshes/visual/bazan/base__cyan.stl

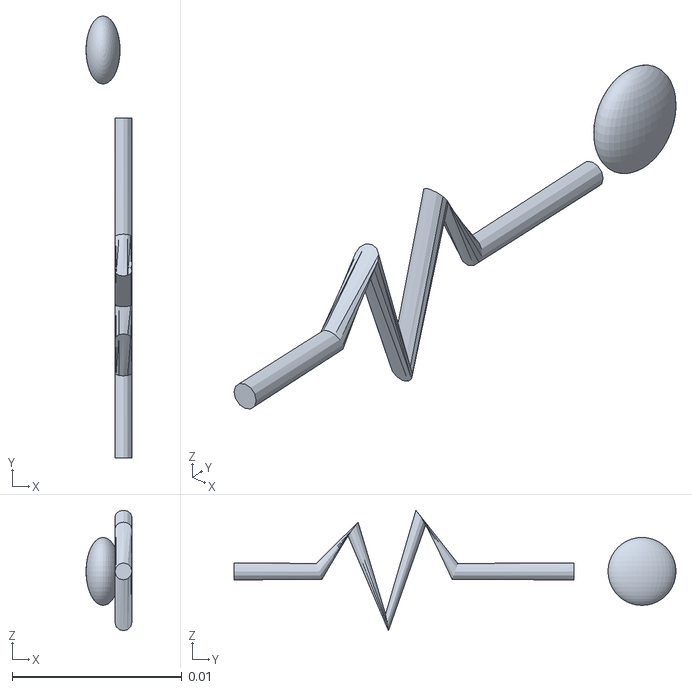
[picture p121: CAD file, 2026-11-10]
software/ros2/src/humanoid_description/meshes/visual/bazan/base__cyan.stl
0.0027 x 0.026 x 0.00709
