nguyenhau442001/Bazan_Humanoid/software/ros2/src/humanoid_description/meshes/visual/bazan/base__orange.stl

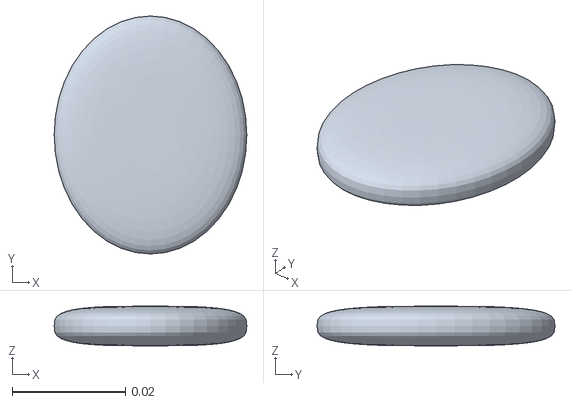
[picture p122: CAD file, 2026-11-10]
software/ros2/src/humanoid_description/meshes/visual/bazan/base__orange.stl
0.034 x 0.042 x 0.007
