nguyenhau442001/Bazan_Humanoid/software/ros2/src/humanoid_description/meshes/visual/bazan/base__white.stl

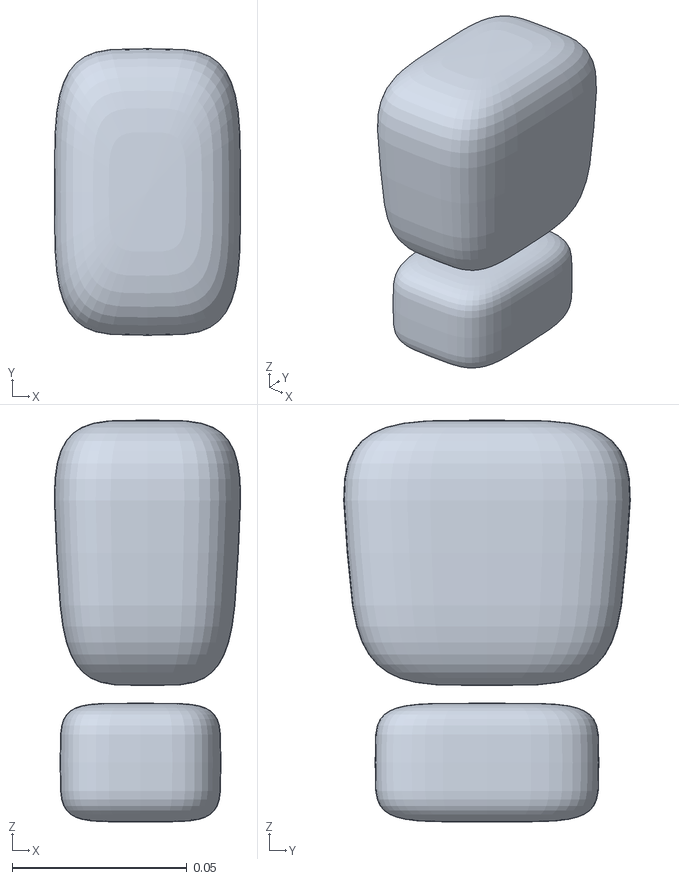
[picture p123: CAD file, 2026-11-10]
software/ros2/src/humanoid_description/meshes/visual/bazan/base__white.stl
0.0533 x 0.082 x 0.115
