nguyenhau442001/Bazan_Humanoid/software/ros2/src/humanoid_description/meshes/visual/bazan/r_ankle_roll__white.stl

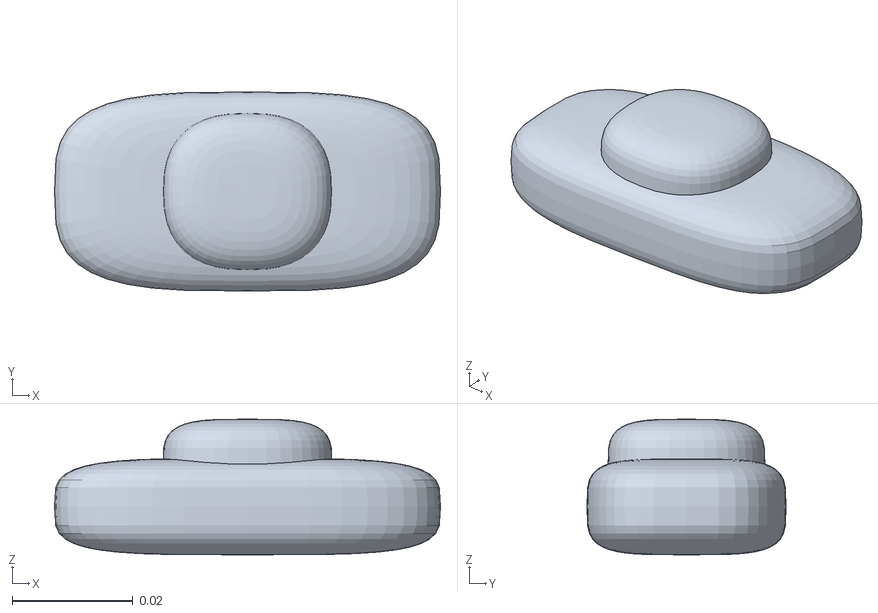
[picture p124: CAD file, 2026-11-10]
software/ros2/src/humanoid_description/meshes/visual/bazan/r_ankle_roll__white.stl
0.064 x 0.033 x 0.0225
