nguyenhau442001/Bazan_Humanoid/software/ros2/src/humanoid_description/meshes/visual/bazan/head_pitch__joint.stl

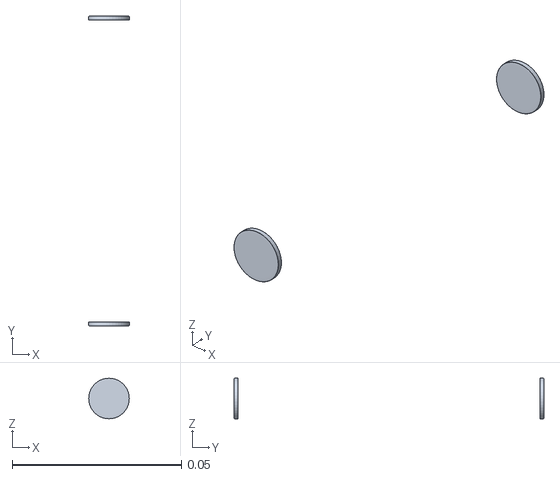
[picture p125: CAD file, 2026-11-10]
software/ros2/src/humanoid_description/meshes/visual/bazan/head_pitch__joint.stl
0.012 x 0.0916 x 0.012
