nguyenhau442001/Bazan_Humanoid/software/ros2/src/humanoid_description/meshes/visual/bazan/r_elbow__joint.stl

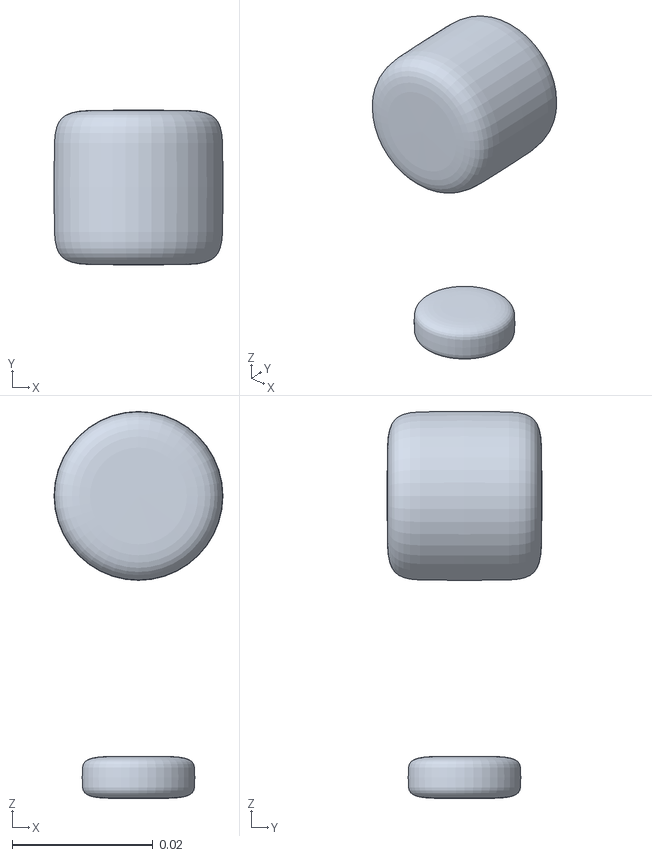
[picture p126: CAD file, 2026-11-10]
software/ros2/src/humanoid_description/meshes/visual/bazan/r_elbow__joint.stl
0.024 x 0.022 x 0.055
