nguyenhau442001/Bazan_Humanoid/software/ros2/src/humanoid_description/meshes/visual/bazan/head_pitch__cyan.stl

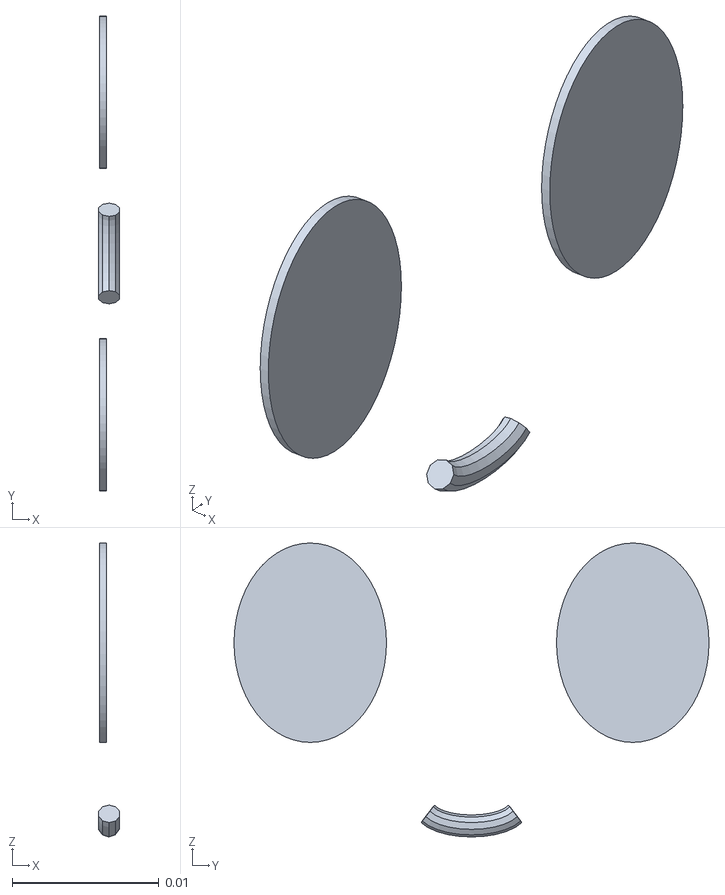
[picture p127: CAD file, 2026-11-10]
software/ros2/src/humanoid_description/meshes/visual/bazan/head_pitch__cyan.stl
0.00145 x 0.0324 x 0.02
