nguyenhau442001/Bazan_Humanoid/software/ros2/src/humanoid_description/meshes/visual/bazan/l_ankle_roll__navy.stl

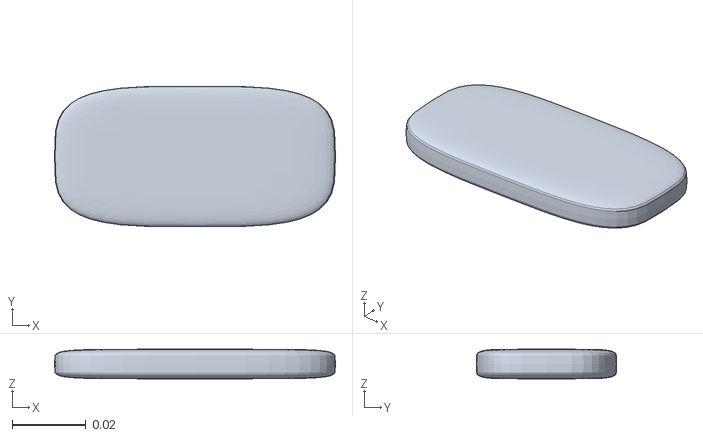
[picture p129: CAD file, 2026-11-10]
software/ros2/src/humanoid_description/meshes/visual/bazan/l_ankle_roll__navy.stl
0.076 x 0.038 x 0.008
