nguyenhau442001/Bazan_Humanoid/software/ros2/src/humanoid_description/meshes/visual/bazan/l_elbow__white.stl

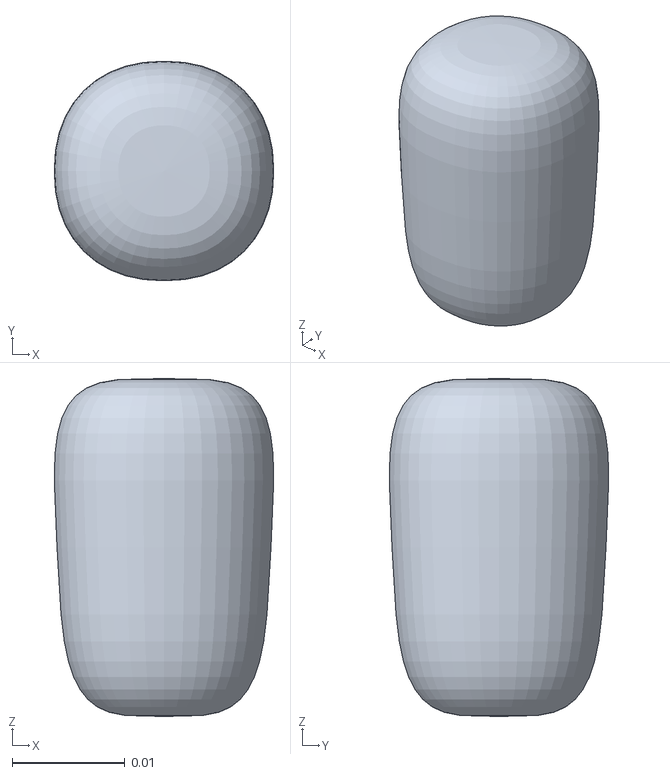
[picture p130: CAD file, 2026-11-10]
software/ros2/src/humanoid_description/meshes/visual/bazan/l_elbow__white.stl
0.0195 x 0.0195 x 0.03
