nguyenhau442001/Bazan_Humanoid/software/ros2/src/humanoid_description/meshes/visual/bazan/base__joint.stl

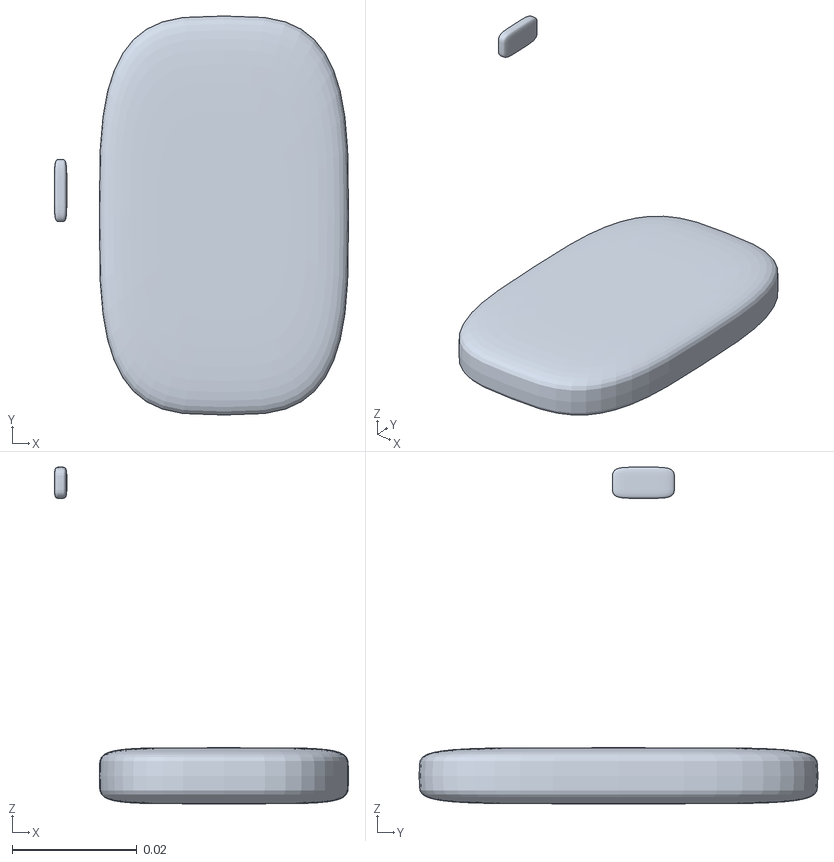
[picture p133: CAD file, 2026-11-10]
software/ros2/src/humanoid_description/meshes/visual/bazan/base__joint.stl
0.0472 x 0.064 x 0.054
