nguyenhau442001/Bazan_Humanoid/software/ros2/src/humanoid_description/meshes/visual/bazan/base__red.stl

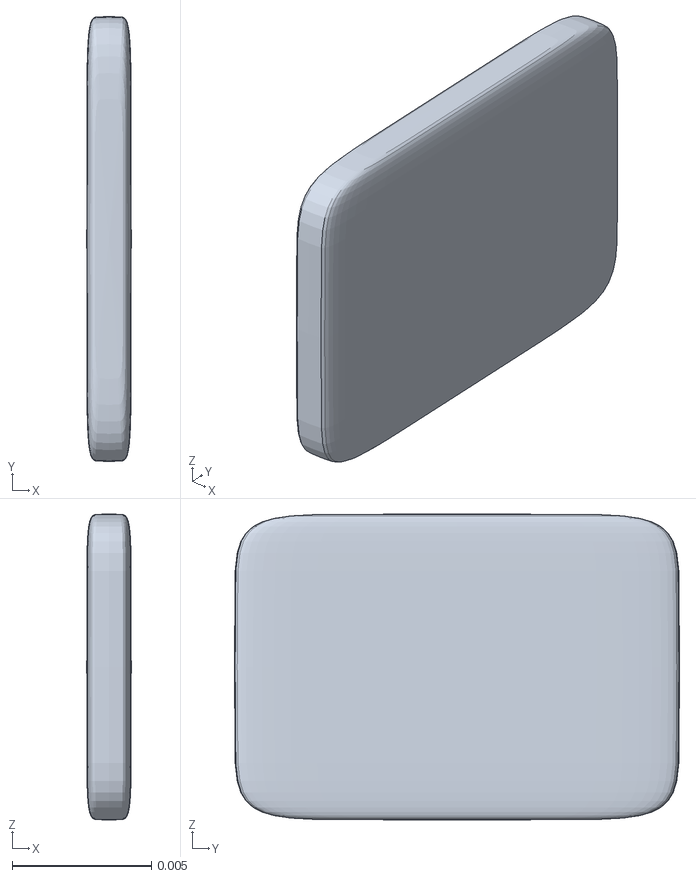
[picture p134: CAD file, 2026-11-10]
software/ros2/src/humanoid_description/meshes/visual/bazan/base__red.stl
0.0016 x 0.016 x 0.011
