nguyenhau442001/Bazan_Humanoid/software/ros2/src/humanoid_description/meshes/visual/bazan/base__visor.stl

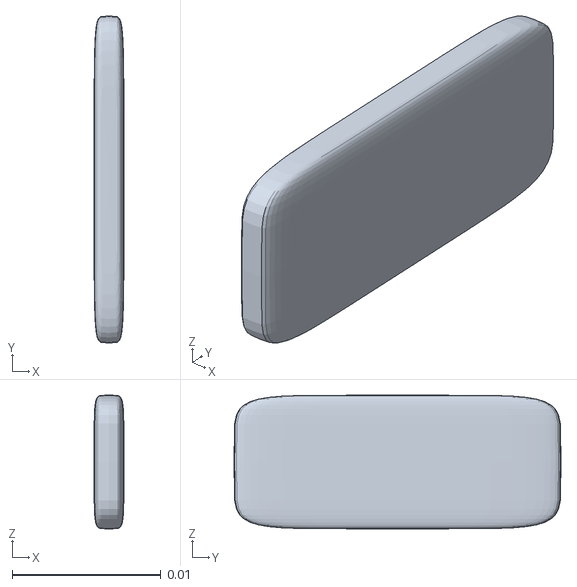
[picture p136: CAD file, 2026-11-10]
software/ros2/src/humanoid_description/meshes/visual/bazan/base__visor.stl
0.002 x 0.022 x 0.009
