nguyenhau442001/Bazan_Humanoid/software/ros2/src/humanoid_description/meshes/visual/bazan/base__grey.stl

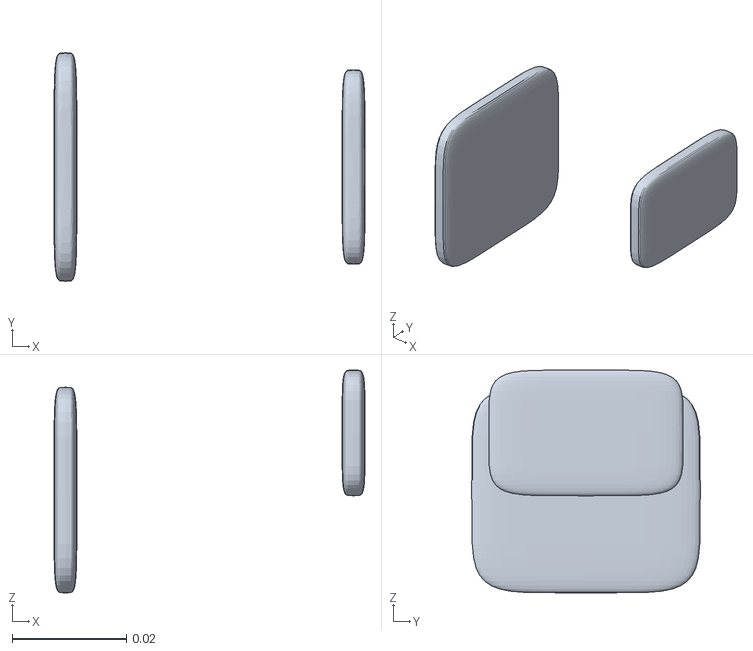
[picture p137: CAD file, 2026-11-10]
software/ros2/src/humanoid_description/meshes/visual/bazan/base__grey.stl
0.0544 x 0.04 x 0.039
