nguyenhau442001/Bazan_Humanoid/(list of files, cad)

Other CAD files:
software/ros2/src/humanoid_description/meshes/visual/bazan/l_shoulder_pitch__orange.stl
software/ros2/src/humanoid_description/meshes/visual/bazan/l_shoulder_pitch__white.stl
software/ros2/src/humanoid_description/meshes/visual/bazan/l_elbow__grey.stl
design/blender/bazan.blend
