nguyenhau442001/Bazan_Humanoid/design/blender/humanoid_blender.urdf

<?xml version="1.0"?>
<!-- Generated by gen_robot.py — edit that file, not this one. -->
<robot name="mini_humanoid">
  <!-- Frames follow REP-103 (x forward, y left, z up) and REP-120 names (imu_link, l_sole, ...).
       base_link sits at the hip point H, 115 mm above the floor in the standing pose. -->
  <material name="battery"><color rgba="0.93 0.55 0.42 1"/></material>
  <material name="frame"><color rgba="0.88 0.88 0.86 1"/></material>
  <material name="hidden"><color rgba="0 0 0 0"/></material>
  <material name="lens"><color rgba="0.1 0.1 0.12 1"/></material>
  <material name="mg90s"><color rgba="0.3 0.36 0.52 1"/></material>
  <material name="mg92b"><color rgba="0.36 0.56 0.9 1"/></material>
  <material name="pcb"><color rgba="0.36 0.75 0.6 1"/></material>
  <material name="sg90"><color rgba="0.45 0.7 0.95 1"/></material>
  <material name="shell"><color rgba="0.95 0.95 0.93 1"/></material>
  <link name="base_link">
    <inertial><origin xyz="-0.0012 -0.0000 0.0656"/><mass value="0.2430"/><inertia ixx="2.452e-04" iyy="1.783e-04" izz="1.238e-04" ixy="-1.595e-17" ixz="2.315e-06" iyz="-5.356e-18"/></inertial>
    <visual name="pelvis"><origin xyz="0.0000 0.0000 0.0210"/><geometry><box size="0.0400 0.0680 0.0360"/></geometry><material name="frame"/></visual>
    <collision name="pelvis_collision"><origin xyz="0.0000 0.0000 0.0210"/><geometry><box size="0.0400 0.0680 0.0360"/></geometry></collision>
    <visual name="torso_shell"><origin xyz="0.0000 0.0000 0.0740"/><geometry><box size="0.0460 0.0740 0.0720"/></geometry><material name="shell"/></visual>
    <collision name="torso_shell_collision"><origin xyz="0.0000 0.0000 0.0740"/><geometry><box size="0.0460 0.0740 0.0720"/></geometry></collision>
    <visual name="battery_2s"><origin xyz="0.0000 0.0000 0.0495"/><geometry><box size="0.0300 0.0560 0.0190"/></geometry><material name="battery"/></visual>
    <collision name="battery_2s_collision"><origin xyz="0.0000 0.0000 0.0495"/><geometry><box size="0.0300 0.0560 0.0190"/></geometry></collision>
    <visual name="electronics"><origin xyz="0.0000 0.0000 0.0750"/><geometry><box size="0.0250 0.0620 0.0250"/></geometry><material name="pcb"/></visual>
    <collision name="electronics_collision"><origin xyz="0.0000 0.0000 0.0750"/><geometry><box size="0.0250 0.0620 0.0250"/></geometry></collision>
    <visual name="ubec"><origin xyz="-0.0170 0.0000 0.0820"/><geometry><box size="0.0080 0.0260 0.0460"/></geometry><material name="pcb"/></visual>
    <collision name="ubec_collision"><origin xyz="-0.0170 0.0000 0.0820"/><geometry><box size="0.0080 0.0260 0.0460"/></geometry></collision>
    <visual name="l_shoulder_pitch_servo"><origin xyz="0.0000 0.0335 0.0960"/><geometry><box size="0.0122 0.0228 0.0285"/></geometry><material name="mg90s"/></visual>
    <collision name="l_shoulder_pitch_servo_collision"><origin xyz="0.0000 0.0335 0.0960"/><geometry><box size="0.0122 0.0228 0.0285"/></geometry></collision>
    <visual name="r_shoulder_pitch_servo"><origin xyz="0.0000 -0.0335 0.0960"/><geometry><box size="0.0122 0.0228 0.0285"/></geometry><material name="mg90s"/></visual>
    <collision name="r_shoulder_pitch_servo_collision"><origin xyz="0.0000 -0.0335 0.0960"/><geometry><box size="0.0122 0.0228 0.0285"/></geometry></collision>
    <visual name="neck_yaw_servo"><origin xyz="0.0000 0.0000 0.0980"/><geometry><box size="0.0122 0.0290 0.0230"/></geometry><material name="sg90"/></visual>
    <collision name="neck_yaw_servo_collision"><origin xyz="0.0000 0.0000 0.0980"/><geometry><box size="0.0122 0.0290 0.0230"/></geometry></collision>
  </link>
  <link name="l_hip_yaw_link">
    <inertial><origin xyz="0.0000 0.0000 0.0180"/><mass value="0.0164"/><inertia ixx="2.962e-06" iyy="2.221e-06" izz="1.361e-06" ixy="0.000e+00" ixz="0.000e+00" iyz="1.455e-20"/></inertial>
    <visual name="l_hip_yaw_servo"><origin xyz="0.0000 0.0000 0.0220"/><geometry><box size="0.0122 0.0285 0.0228"/></geometry><material name="mg90s"/></visual>
    <collision name="l_hip_yaw_servo_collision"><origin xyz="0.0000 0.0000 0.0220"/><geometry><box size="0.0122 0.0285 0.0228"/></geometry></collision>
  </link>
  <link name="l_hip_roll_link">
    <inertial><origin xyz="-0.0093 0.0000 -0.0008"/><mass value="0.0210"/><inertia ixx="2.708e-06" iyy="3.223e-06" izz="2.564e-06" ixy="-9.095e-22" ixz="1.505e-07" iyz="0.000e+00"/></inertial>
    <visual name="l_hip_roll_servo"><origin xyz="-0.0140 0.0000 0.0000"/><geometry><box size="0.0120 0.0228 0.0310"/></geometry><material name="mg92b"/></visual>
    <collision name="l_hip_roll_servo_collision"><origin xyz="-0.0140 0.0000 0.0000"/><geometry><box size="0.0120 0.0228 0.0310"/></geometry></collision>
  </link>
  <link name="l_hip_pitch_link">
    <inertial><origin xyz="0.0000 -0.0000 -0.0111"/><mass value="0.0219"/><inertia ixx="3.905e-06" iyy="4.386e-06" izz="1.760e-06" ixy="1.209e-22" ixz="5.691e-22" iyz="-1.455e-20"/></inertial>
    <visual name="l_hip_pitch_servo"><origin xyz="0.0000 0.0000 -0.0090"/><geometry><box size="0.0228 0.0120 0.0310"/></geometry><material name="mg92b"/></visual>
    <collision name="l_hip_pitch_servo_collision"><origin xyz="0.0000 0.0000 -0.0090"/><geometry><box size="0.0228 0.0120 0.0310"/></geometry></collision>
    <visual name="l_thigh"><origin xyz="0.0000 0.0000 -0.0225"/><geometry><box size="0.0180 0.0180 0.0450"/></geometry><material name="shell"/></visual>
    <collision name="l_thigh_collision"><origin xyz="0.0000 0.0000 -0.0225"/><geometry><box size="0.0180 0.0180 0.0450"/></geometry></collision>
  </link>
  <link name="l_knee_link">
    <inertial><origin xyz="-0.0000 -0.0000 -0.0041"/><mass value="0.0240"/><inertia ixx="4.645e-06" iyy="5.121e-06" izz="1.903e-06" ixy="-4.953e-23" ixz="2.519e-22" iyz="-7.276e-21"/></inertial>
    <visual name="l_knee_servo"><origin xyz="0.0000 0.0000 0.0000"/><geometry><box size="0.0228 0.0120 0.0310"/></geometry><material name="mg92b"/></visual>
    <collision name="l_knee_servo_collision"><origin xyz="0.0000 0.0000 0.0000"/><geometry><box size="0.0228 0.0120 0.0310"/></geometry></collision>
    <visual name="l_shin"><origin xyz="0.0000 0.0000 -0.0225"/><geometry><box size="0.0180 0.0180 0.0450"/></geometry><material name="shell"/></visual>
    <collision name="l_shin_collision"><origin xyz="0.0000 0.0000 -0.0225"/><geometry><box size="0.0180 0.0180 0.0450"/></geometry></collision>
  </link>
  <link name="l_ankle_pitch_link">
    <inertial><origin xyz="0.0000 -0.0000 0.0083"/><mass value="0.0198"/><inertia ixx="2.207e-06" iyy="2.668e-06" izz="1.423e-06" ixy="-1.759e-23" ixz="2.317e-23" iyz="-5.457e-21"/></inertial>
    <visual name="l_ankle_pitch_servo"><origin xyz="0.0000 0.0000 0.0110"/><geometry><box size="0.0228 0.0120 0.0310"/></geometry><material name="mg92b"/></visual>
    <collision name="l_ankle_pitch_servo_collision"><origin xyz="0.0000 0.0000 0.0110"/><geometry><box size="0.0228 0.0120 0.0310"/></geometry></collision>
  </link>
  <link name="l_ankle_roll_link">
    <inertial><origin xyz="-0.0047 0.0003 -0.0099"/><mass value="0.0372"/><inertia ixx="7.028e-06" iyy="1.349e-05" izz="1.177e-05" ixy="-1.768e-07" ixz="1.824e-06" iyz="1.697e-07"/></inertial>
    <visual name="l_ankle_roll_servo"><origin xyz="-0.0140 0.0000 -0.0020"/><geometry><box size="0.0120 0.0228 0.0310"/></geometry><material name="mg92b"/></visual>
    <collision name="l_ankle_roll_servo_collision"><origin xyz="-0.0140 0.0000 -0.0020"/><geometry><box size="0.0120 0.0228 0.0310"/></geometry></collision>
    <visual name="l_foot"><origin xyz="0.0000 0.0000 -0.0210"/><geometry><box size="0.0760 0.0380 0.0080"/></geometry><material name="frame"/></visual>
    <collision name="l_foot_collision"><origin xyz="0.0000 0.0000 -0.0210"/><geometry><box size="0.0760 0.0380 0.0080"/></geometry></collision>
  </link>
  <link name="r_hip_yaw_link">
    <inertial><origin xyz="0.0000 -0.0000 0.0180"/><mass value="0.0164"/><inertia ixx="2.962e-06" iyy="2.221e-06" izz="1.361e-06" ixy="0.000e+00" ixz="0.000e+00" iyz="-1.455e-20"/></inertial>
    <visual name="r_hip_yaw_servo"><origin xyz="0.0000 0.0000 0.0220"/><geometry><box size="0.0122 0.0285 0.0228"/></geometry><material name="mg90s"/></visual>
    <collision name="r_hip_yaw_servo_collision"><origin xyz="0.0000 0.0000 0.0220"/><geometry><box size="0.0122 0.0285 0.0228"/></geometry></collision>
  </link>
  <link name="r_hip_roll_link">
    <inertial><origin xyz="-0.0093 -0.0000 -0.0008"/><mass value="0.0210"/><inertia ixx="2.708e-06" iyy="3.223e-06" izz="2.564e-06" ixy="9.095e-22" ixz="1.505e-07" iyz="-2.910e-20"/></inertial>
    <visual name="r_hip_roll_servo"><origin xyz="-0.0140 0.0000 0.0000"/><geometry><box size="0.0120 0.0228 0.0310"/></geometry><material name="mg92b"/></visual>
    <collision name="r_hip_roll_servo_collision"><origin xyz="-0.0140 0.0000 0.0000"/><geometry><box size="0.0120 0.0228 0.0310"/></geometry></collision>
  </link>
  <link name="r_hip_pitch_link">
    <inertial><origin xyz="0.0000 0.0000 -0.0111"/><mass value="0.0219"/><inertia ixx="3.905e-06" iyy="4.386e-06" izz="1.760e-06" ixy="-2.855e-23" ixz="3.904e-22" iyz="-7.276e-21"/></inertial>
    <visual name="r_hip_pitch_servo"><origin xyz="0.0000 0.0000 -0.0090"/><geometry><box size="0.0228 0.0120 0.0310"/></geometry><material name="mg92b"/></visual>
    <collision name="r_hip_pitch_servo_collision"><origin xyz="0.0000 0.0000 -0.0090"/><geometry><box size="0.0228 0.0120 0.0310"/></geometry></collision>
    <visual name="r_thigh"><origin xyz="0.0000 0.0000 -0.0225"/><geometry><box size="0.0180 0.0180 0.0450"/></geometry><material name="shell"/></visual>
    <collision name="r_thigh_collision"><origin xyz="0.0000 0.0000 -0.0225"/><geometry><box size="0.0180 0.0180 0.0450"/></geometry></collision>
  </link>
  <link name="r_knee_link">
    <inertial><origin xyz="0.0000 0.0000 -0.0041"/><mass value="0.0240"/><inertia ixx="4.645e-06" iyy="5.121e-06" izz="1.903e-06" ixy="-8.938e-24" ixz="5.088e-22" iyz="2.183e-20"/></inertial>
    <visual name="r_knee_servo"><origin xyz="0.0000 0.0000 0.0000"/><geometry><box size="0.0228 0.0120 0.0310"/></geometry><material name="mg92b"/></visual>
    <collision name="r_knee_servo_collision"><origin xyz="0.0000 0.0000 0.0000"/><geometry><box size="0.0228 0.0120 0.0310"/></geometry></collision>
    <visual name="r_shin"><origin xyz="0.0000 0.0000 -0.0225"/><geometry><box size="0.0180 0.0180 0.0450"/></geometry><material name="shell"/></visual>
    <collision name="r_shin_collision"><origin xyz="0.0000 0.0000 -0.0225"/><geometry><box size="0.0180 0.0180 0.0450"/></geometry></collision>
  </link>
  <link name="r_ankle_pitch_link">
    <inertial><origin xyz="0.0000 0.0000 0.0083"/><mass value="0.0198"/><inertia ixx="2.207e-06" iyy="2.668e-06" izz="1.423e-06" ixy="9.135e-24" ixz="-4.011e-23" iyz="5.457e-21"/></inertial>
    <visual name="r_ankle_pitch_servo"><origin xyz="0.0000 0.0000 0.0110"/><geometry><box size="0.0228 0.0120 0.0310"/></geometry><material name="mg92b"/></visual>
    <collision name="r_ankle_pitch_servo_collision"><origin xyz="0.0000 0.0000 0.0110"/><geometry><box size="0.0228 0.0120 0.0310"/></geometry></collision>
  </link>
  <link name="r_ankle_roll_link">
    <inertial><origin xyz="-0.0047 -0.0003 -0.0099"/><mass value="0.0372"/><inertia ixx="7.028e-06" iyy="1.349e-05" izz="1.177e-05" ixy="1.768e-07" ixz="1.824e-06" iyz="-1.697e-07"/></inertial>
    <visual name="r_ankle_roll_servo"><origin xyz="-0.0140 0.0000 -0.0020"/><geometry><box size="0.0120 0.0228 0.0310"/></geometry><material name="mg92b"/></visual>
    <collision name="r_ankle_roll_servo_collision"><origin xyz="-0.0140 0.0000 -0.0020"/><geometry><box size="0.0120 0.0228 0.0310"/></geometry></collision>
    <visual name="r_foot"><origin xyz="0.0000 0.0000 -0.0210"/><geometry><box size="0.0760 0.0380 0.0080"/></geometry><material name="frame"/></visual>
    <collision name="r_foot_collision"><origin xyz="0.0000 0.0000 -0.0210"/><geometry><box size="0.0760 0.0380 0.0080"/></geometry></collision>
  </link>
  <link name="l_shoulder_pitch_link">
    <inertial><origin xyz="-0.0000 0.0064 -0.0016"/><mass value="0.0074"/><inertia ixx="1.660e-06" iyy="1.421e-06" izz="1.655e-06" ixy="1.053e-21" ixz="-7.329e-22" iyz="1.914e-08"/></inertial>
    <visual name="l_shoulder_cap"><origin xyz="0.0000 0.0050 0.0000"/><geometry><box size="0.0180 0.0140 0.0280"/></geometry><material name="shell"/></visual>
    <collision name="l_shoulder_cap_collision"><origin xyz="0.0000 0.0050 0.0000"/><geometry><box size="0.0180 0.0140 0.0280"/></geometry></collision>
  </link>
  <link name="l_shoulder_roll_link">
    <inertial><origin xyz="-0.0000 0.0000 -0.0098"/><mass value="0.0132"/><inertia ixx="2.713e-06" iyy="2.194e-06" izz="1.093e-06" ixy="-4.558e-23" ixz="-2.751e-22" iyz="8.731e-20"/></inertial>
    <visual name="l_shoulder_roll_servo"><origin xyz="0.0000 0.0000 -0.0060"/><geometry><box size="0.0122 0.0290 0.0230"/></geometry><material name="sg90"/></visual>
    <collision name="l_shoulder_roll_servo_collision"><origin xyz="0.0000 0.0000 -0.0060"/><geometry><box size="0.0122 0.0290 0.0230"/></geometry></collision>
    <visual name="l_upper_arm"><origin xyz="0.0000 0.0000 -0.0300"/><geometry><box size="0.0160 0.0160 0.0360"/></geometry><material name="shell"/></visual>
    <collision name="l_upper_arm_collision"><origin xyz="0.0000 0.0000 -0.0300"/><geometry><box size="0.0160 0.0160 0.0360"/></geometry></collision>
  </link>
  <link name="l_elbow_link">
    <inertial><origin xyz="0.0001 -0.0000 -0.0071"/><mass value="0.0170"/><inertia ixx="4.995e-06" iyy="5.285e-06" izz="1.175e-06" ixy="2.604e-09" ixz="4.857e-08" iyz="-1.388e-08"/></inertial>
    <visual name="l_elbow_servo"><origin xyz="0.0000 0.0000 0.0000"/><geometry><box size="0.0230 0.0122 0.0290"/></geometry><material name="sg90"/></visual>
    <collision name="l_elbow_servo_collision"><origin xyz="0.0000 0.0000 0.0000"/><geometry><box size="0.0230 0.0122 0.0290"/></geometry></collision>
    <visual name="l_forearm"><origin xyz="0.0000 0.0000 -0.0190"/><geometry><box size="0.0140 0.0140 0.0380"/></geometry><material name="shell"/></visual>
    <collision name="l_forearm_collision"><origin xyz="0.0000 0.0000 -0.0190"/><geometry><box size="0.0140 0.0140 0.0380"/></geometry></collision>
    <visual name="l_hand"><origin xyz="0.0000 0.0000 -0.0440"/><geometry><box size="0.0140 0.0140 0.0140"/></geometry><material name="shell"/></visual>
    <collision name="l_hand_collision"><origin xyz="0.0000 0.0000 -0.0440"/><geometry><box size="0.0140 0.0140 0.0140"/></geometry></collision>
  </link>
  <link name="r_shoulder_pitch_link">
    <inertial><origin xyz="-0.0000 -0.0064 -0.0016"/><mass value="0.0074"/><inertia ixx="1.660e-06" iyy="1.421e-06" izz="1.655e-06" ixy="5.555e-22" ixz="-7.624e-21" iyz="-1.914e-08"/></inertial>
    <visual name="r_shoulder_cap"><origin xyz="0.0000 -0.0050 0.0000"/><geometry><box size="0.0180 0.0140 0.0280"/></geometry><material name="shell"/></visual>
    <collision name="r_shoulder_cap_collision"><origin xyz="0.0000 -0.0050 0.0000"/><geometry><box size="0.0180 0.0140 0.0280"/></geometry></collision>
  </link>
  <link name="r_shoulder_roll_link">
    <inertial><origin xyz="-0.0000 0.0000 -0.0098"/><mass value="0.0132"/><inertia ixx="2.713e-06" iyy="2.194e-06" izz="1.093e-06" ixy="4.353e-23" ixz="-2.171e-22" iyz="-8.731e-20"/></inertial>
    <visual name="r_shoulder_roll_servo"><origin xyz="0.0000 0.0000 -0.0060"/><geometry><box size="0.0122 0.0290 0.0230"/></geometry><material name="sg90"/></visual>
    <collision name="r_shoulder_roll_servo_collision"><origin xyz="0.0000 0.0000 -0.0060"/><geometry><box size="0.0122 0.0290 0.0230"/></geometry></collision>
    <visual name="r_upper_arm"><origin xyz="0.0000 0.0000 -0.0300"/><geometry><box size="0.0160 0.0160 0.0360"/></geometry><material name="shell"/></visual>
    <collision name="r_upper_arm_collision"><origin xyz="0.0000 0.0000 -0.0300"/><geometry><box size="0.0160 0.0160 0.0360"/></geometry></collision>
  </link>
  <link name="r_elbow_link">
    <inertial><origin xyz="0.0001 0.0000 -0.0071"/><mass value="0.0170"/><inertia ixx="4.995e-06" iyy="5.285e-06" izz="1.175e-06" ixy="-2.604e-09" ixz="4.857e-08" iyz="1.388e-08"/></inertial>
    <visual name="r_elbow_servo"><origin xyz="0.0000 0.0000 0.0000"/><geometry><box size="0.0230 0.0122 0.0290"/></geometry><material name="sg90"/></visual>
    <collision name="r_elbow_servo_collision"><origin xyz="0.0000 0.0000 0.0000"/><geometry><box size="0.0230 0.0122 0.0290"/></geometry></collision>
    <visual name="r_forearm"><origin xyz="0.0000 0.0000 -0.0190"/><geometry><box size="0.0140 0.0140 0.0380"/></geometry><material name="shell"/></visual>
    <collision name="r_forearm_collision"><origin xyz="0.0000 0.0000 -0.0190"/><geometry><box size="0.0140 0.0140 0.0380"/></geometry></collision>
    <visual name="r_hand"><origin xyz="0.0000 0.0000 -0.0440"/><geometry><box size="0.0140 0.0140 0.0140"/></geometry><material name="shell"/></visual>
    <collision name="r_hand_collision"><origin xyz="0.0000 0.0000 -0.0440"/><geometry><box size="0.0140 0.0140 0.0140"/></geometry></collision>
  </link>
  <link name="neck_yaw_link">
    <inertial><origin xyz="0.0000 -0.0000 0.0171"/><mass value="0.0128"/><inertia ixx="2.190e-06" iyy="1.852e-06" izz="9.115e-07" ixy="-7.176e-23" ixz="7.033e-22" iyz="-2.873e-22"/></inertial>
    <visual name="neck"><origin xyz="0.0000 0.0000 0.0050"/><geometry><box size="0.0160 0.0160 0.0100"/></geometry><material name="frame"/></visual>
    <collision name="neck_collision"><origin xyz="0.0000 0.0000 0.0050"/><geometry><box size="0.0160 0.0160 0.0100"/></geometry></collision>
    <visual name="head_pitch_servo"><origin xyz="0.0000 0.0000 0.0220"/><geometry><box size="0.0122 0.0230 0.0290"/></geometry><material name="sg90"/></visual>
    <collision name="head_pitch_servo_collision"><origin xyz="0.0000 0.0000 0.0220"/><geometry><box size="0.0122 0.0230 0.0290"/></geometry></collision>
  </link>
  <link name="head_pitch_link">
    <inertial><origin xyz="0.0093 0.0002 0.0250"/><mass value="0.0651"/><inertia ixx="5.519e-05" iyy="4.735e-05" izz="6.010e-05" ixy="-2.249e-07" ixz="-1.853e-06" iyz="-2.406e-07"/></inertial>
    <visual name="head_shell"><origin xyz="0.0020 0.0000 0.0240"/><geometry><box size="0.0620 0.0740 0.0640"/></geometry><material name="shell"/></visual>
    <collision name="head_shell_collision"><origin xyz="0.0020 0.0000 0.0240"/><geometry><box size="0.0620 0.0740 0.0640"/></geometry></collision>
    <visual name="visor"><origin xyz="0.0340 0.0000 0.0240"/><geometry><box size="0.0020 0.0580 0.0260"/></geometry><material name="lens"/></visual>
    <collision name="visor_collision"><origin xyz="0.0340 0.0000 0.0240"/><geometry><box size="0.0020 0.0580 0.0260"/></geometry></collision>
    <visual name="camera"><origin xyz="0.0280 0.0000 0.0240"/><geometry><box size="0.0060 0.0250 0.0240"/></geometry><material name="pcb"/></visual>
    <collision name="camera_collision"><origin xyz="0.0280 0.0000 0.0240"/><geometry><box size="0.0060 0.0250 0.0240"/></geometry></collision>
  </link>
  <joint name="l_hip_yaw" type="revolute"><parent link="base_link"/><child link="l_hip_yaw_link"/><origin xyz="0.0000 0.0220 0.0000"/><axis xyz="0 0 1"/><limit lower="-0.7854" upper="0.7854" effort="0.216" velocity="13.09"/><dynamics damping="0.02" friction="0"/></joint>
  <joint name="r_hip_yaw" type="revolute"><parent link="base_link"/><child link="r_hip_yaw_link"/><origin xyz="0.0000 -0.0220 0.0000"/><axis xyz="0 0 1"/><limit lower="-0.7854" upper="0.7854" effort="0.216" velocity="13.09"/><dynamics damping="0.02" friction="0"/></joint>
  <joint name="l_shoulder_pitch" type="revolute"><parent link="base_link"/><child link="l_shoulder_pitch_link"/><origin xyz="0.0000 0.0500 0.0970"/><axis xyz="0 1 0"/><limit lower="-3.1416" upper="1.0472" effort="0.216" velocity="13.09"/><dynamics damping="0.02" friction="0"/></joint>
  <joint name="r_shoulder_pitch" type="revolute"><parent link="base_link"/><child link="r_shoulder_pitch_link"/><origin xyz="0.0000 -0.0500 0.0970"/><axis xyz="0 1 0"/><limit lower="-3.1416" upper="1.0472" effort="0.216" velocity="13.09"/><dynamics damping="0.02" friction="0"/></joint>
  <joint name="neck_yaw" type="revolute"><parent link="base_link"/><child link="neck_yaw_link"/><origin xyz="0.0000 0.0000 0.1100"/><axis xyz="0 0 1"/><limit lower="-1.5708" upper="1.5708" effort="0.177" velocity="10.47"/><dynamics damping="0.02" friction="0"/></joint>
  <joint name="l_hip_roll" type="revolute"><parent link="l_hip_yaw_link"/><child link="l_hip_roll_link"/><origin xyz="0.0000 0.0000 0.0000"/><axis xyz="1 0 0"/><limit lower="-0.4363" upper="0.4363" effort="0.343" velocity="13.09"/><dynamics damping="0.02" friction="0"/></joint>
  <joint name="l_hip_pitch" type="revolute"><parent link="l_hip_roll_link"/><child link="l_hip_pitch_link"/><origin xyz="0.0000 0.0000 0.0000"/><axis xyz="0 1 0"/><limit lower="-1.5708" upper="0.7854" effort="0.343" velocity="13.09"/><dynamics damping="0.02" friction="0"/></joint>
  <joint name="l_knee" type="revolute"><parent link="l_hip_pitch_link"/><child link="l_knee_link"/><origin xyz="0.0000 0.0000 -0.0450"/><axis xyz="0 1 0"/><limit lower="0.0000" upper="2.0944" effort="0.343" velocity="13.09"/><dynamics damping="0.02" friction="0"/></joint>
  <joint name="l_ankle_pitch" type="revolute"><parent link="l_knee_link"/><child link="l_ankle_pitch_link"/><origin xyz="0.0000 0.0000 -0.0450"/><axis xyz="0 1 0"/><limit lower="-0.7854" upper="0.7854" effort="0.343" velocity="13.09"/><dynamics damping="0.02" friction="0"/></joint>
  <joint name="l_ankle_roll" type="revolute"><parent link="l_ankle_pitch_link"/><child link="l_ankle_roll_link"/><origin xyz="0.0000 0.0000 0.0000"/><axis xyz="1 0 0"/><limit lower="-0.5236" upper="0.5236" effort="0.343" velocity="13.09"/><dynamics damping="0.02" friction="0"/></joint>
  <joint name="r_hip_roll" type="revolute"><parent link="r_hip_yaw_link"/><child link="r_hip_roll_link"/><origin xyz="0.0000 0.0000 0.0000"/><axis xyz="1 0 0"/><limit lower="-0.4363" upper="0.4363" effort="0.343" velocity="13.09"/><dynamics damping="0.02" friction="0"/></joint>
  <joint name="r_hip_pitch" type="revolute"><parent link="r_hip_roll_link"/><child link="r_hip_pitch_link"/><origin xyz="0.0000 0.0000 0.0000"/><axis xyz="0 1 0"/><limit lower="-1.5708" upper="0.7854" effort="0.343" velocity="13.09"/><dynamics damping="0.02" friction="0"/></joint>
  <joint name="r_knee" type="revolute"><parent link="r_hip_pitch_link"/><child link="r_knee_link"/><origin xyz="0.0000 0.0000 -0.0450"/><axis xyz="0 1 0"/><limit lower="0.0000" upper="2.0944" effort="0.343" velocity="13.09"/><dynamics damping="0.02" friction="0"/></joint>
  <joint name="r_ankle_pitch" type="revolute"><parent link="r_knee_link"/><child link="r_ankle_pitch_link"/><origin xyz="0.0000 0.0000 -0.0450"/><axis xyz="0 1 0"/><limit lower="-0.7854" upper="0.7854" effort="0.343" velocity="13.09"/><dynamics damping="0.02" friction="0"/></joint>
  <joint name="r_ankle_roll" type="revolute"><parent link="r_ankle_pitch_link"/><child link="r_ankle_roll_link"/><origin xyz="0.0000 0.0000 0.0000"/><axis xyz="1 0 0"/><limit lower="-0.5236" upper="0.5236" effort="0.343" velocity="13.09"/><dynamics damping="0.02" friction="0"/></joint>
  <joint name="l_shoulder_roll" type="revolute"><parent link="l_shoulder_pitch_link"/><child link="l_shoulder_roll_link"/><origin xyz="0.0000 0.0050 0.0000"/><axis xyz="1 0 0"/><limit lower="-0.1745" upper="2.7925" effort="0.177" velocity="10.47"/><dynamics damping="0.02" friction="0"/></joint>
  <joint name="l_elbow" type="revolute"><parent link="l_shoulder_roll_link"/><child link="l_elbow_link"/><origin xyz="0.0000 0.0000 -0.0500"/><axis xyz="0 1 0"/><limit lower="-2.2689" upper="0.0000" effort="0.177" velocity="10.47"/><dynamics damping="0.02" friction="0"/></joint>
  <joint name="r_shoulder_roll" type="revolute"><parent link="r_shoulder_pitch_link"/><child link="r_shoulder_roll_link"/><origin xyz="0.0000 -0.0050 0.0000"/><axis xyz="1 0 0"/><limit lower="-2.7925" upper="0.1745" effort="0.177" velocity="10.47"/><dynamics damping="0.02" friction="0"/></joint>
  <joint name="r_elbow" type="revolute"><parent link="r_shoulder_roll_link"/><child link="r_elbow_link"/><origin xyz="0.0000 0.0000 -0.0500"/><axis xyz="0 1 0"/><limit lower="-2.2689" upper="0.0000" effort="0.177" velocity="10.47"/><dynamics damping="0.02" friction="0"/></joint>
  <joint name="head_pitch" type="revolute"><parent link="neck_yaw_link"/><child link="head_pitch_link"/><origin xyz="0.0000 0.0000 0.0220"/><axis xyz="0 1 0"/><limit lower="-0.5236" upper="0.5585" effort="0.177" velocity="10.47"/><dynamics damping="0.02" friction="0"/></joint>
  <link name="imu_link"/>
  <joint name="imu_link_joint" type="fixed"><parent link="base_link"/><child link="imu_link"/><origin xyz="0.0000 0.0000 0.0300" rpy="0.000000 0.000000 0.000000"/></joint>
  <link name="camera_link"/>
  <joint name="camera_link_joint" type="fixed"><parent link="head_pitch_link"/><child link="camera_link"/><origin xyz="0.0310 0.0000 0.0420" rpy="0.000000 0.261799 0.000000"/></joint>
  <link name="tof_link"/>
  <joint name="tof_link_joint" type="fixed"><parent link="head_pitch_link"/><child link="tof_link"/><origin xyz="0.0310 0.0080 0.0450" rpy="0.000000 0.349066 0.000000"/></joint>
  <link name="l_mic_link"/>
  <joint name="l_mic_link_joint" type="fixed"><parent link="head_pitch_link"/><child link="l_mic_link"/><origin xyz="0.0020 0.0385 0.0240" rpy="0.000000 0.000000 1.570796"/></joint>
  <link name="r_mic_link"/>
  <joint name="r_mic_link_joint" type="fixed"><parent link="head_pitch_link"/><child link="r_mic_link"/><origin xyz="0.0020 -0.0385 0.0240" rpy="0.000000 0.000000 -1.570796"/></joint>
  <link name="l_sole"/>
  <joint name="l_sole_joint" type="fixed"><parent link="l_ankle_roll_link"/><child link="l_sole"/><origin xyz="0.0000 0.0000 -0.0250" rpy="0.000000 0.000000 0.000000"/></joint>
  <link name="r_sole"/>
  <joint name="r_sole_joint" type="fixed"><parent link="r_ankle_roll_link"/><child link="r_sole"/><origin xyz="0.0000 0.0000 -0.0250" rpy="0.000000 0.000000 0.000000"/></joint>
  <link name="l_gripper"/>
  <joint name="l_gripper_joint" type="fixed"><parent link="l_elbow_link"/><child link="l_gripper"/><origin xyz="0.0000 0.0000 -0.0440" rpy="0.000000 0.000000 0.000000"/></joint>
  <link name="r_gripper"/>
  <joint name="r_gripper_joint" type="fixed"><parent link="r_elbow_link"/><child link="r_gripper"/><origin xyz="0.0000 0.0000 -0.0440" rpy="0.000000 0.000000 0.000000"/></joint>
  <link name="camera_optical_frame"/>
  <joint name="camera_optical_joint" type="fixed"><parent link="camera_link"/><child link="camera_optical_frame"/><origin xyz="0 0 0" rpy="-1.570796 0.000000 -1.570796"/></joint>
</robot>
