nguyenhau442001/Bazan_Humanoid/(commit log)

2026-11-07 feat(design): establish bill of materials and cost breakdown documentation
2026-11-07 feat(design): specify kinematic joint limits and mechanical travel constraints
2026-11-07 feat(design): define REP-103 and REP-120 coordinate frames and TF tree specification
2026-11-08 feat(design): compute full link mass budget, inertial tensors and CoM distribution
    [humanoid_blender.urdf, links_mass.csv, parts_mass.csv]
2026-11-08 feat(cad): define parametric servo joint dimensions and horn geometry
2026-11-08 feat(cad): implement parametric leg kinematics and 6-DOF joint bracket generator
2026-11-08 feat(cad): implement torso and head structural mounting enclosures
2026-11-08 feat(cad): assemble full 20-DOF kinematic robot structure generator
2026-11-08 feat(cad): implement mechanical collision checking and servo travel verification
    [check.py]
2026-11-08 feat(cad): implement OpenSCAD and FreeCAD automated rendering pipeline
2026-11-08 feat(cad): implement automated mechanical documentation and assembly manual generators
2026-11-08 feat(blender): create master 3D Blender scene for robot visualization
    [mico.blend]
2026-11-08 feat(core): implement lock-free byte ring buffer and frame synchronization
2026-11-08 feat(core): implement high-resolution monotonic timer and loop statistics tracker
2026-11-09 feat(core): implement joint state conversions and unit mapping
2026-11-09 feat(core): implement real-time joint limit and velocity safety supervisor
2026-11-09 feat(core): implement deterministic protocol serialization and joint lookup tables
2026-11-09 test(core): implement unit tests for multi-threaded concurrency and lock-free rings
2026-11-09 feat(firmware): initialize STM32F411CEU6 BlackPill CMSIS and HAL driver baseline
2026-11-09 feat(firmware): configure STM32F4xx HAL peripheral drivers for system bus and core (1/2)
2026-11-09 feat(firmware): configure STM32F4xx HAL peripheral drivers for I2C, SPI, TIM and UART (2/2)
2026-11-09 feat(firmware): implement STM32F411 hardware startup, clock tree and interrupt handlers
2026-11-09 feat(firmware): implement FreeRTOS servo task execution and hardware diagnostics
2026-11-09 feat(firmware): implement physical STM32 board abstraction and joint calibration mapping
2026-11-10 feat(ros2): add Bazan shell STL meshes for RViz2 visual representation (1/2)
    [base__cyan.stl, base__grey.stl, base__joint.stl, base__orange.stl, base__red.stl, base__visor.stl, base__white.stl, base__yellow.stl]
2026-11-10 feat(ros2): add Bazan shell STL meshes for RViz2 visual representation (2/2)
    [l_hip_pitch__white.stl, l_hip_roll__joint.stl, l_knee__joint.stl, l_knee__orange.stl, l_knee__white.stl, l_shoulder_pitch__orange.stl, l_shoulder_pitch__white.stl, l_shoulder_roll__white.stl]
2026-11-10 feat(ros2): implement Bazan URDF/Xacro parametric robot description
    [mico.urdf.xacro]
2026-11-10 feat(ros2): implement robot kinematic inspection launch file
2026-11-10 feat(ros2): implement joint state publisher and kinematics trajectory bridge
    [humanoid_controllers.yaml]
2026-11-10 feat(ros2): implement smooth cinematic wave gesture and joint trajectory generator
2026-11-10 test(ros2): add unit tests for kinematic playback and gesture trajectories
2026-11-10 feat(sim): generate standalone URDF for high-performance physics simulation
    [humanoid.urdf]
2026-11-10 feat(sim): compute multi-body forward kinematics and rigid body dynamics
    [dh_table.csv, joints_kin_dyn.csv, links_dynamics.csv, mj_servo_loads.csv]
2026-11-10 feat(sim): generate native MuJoCo MJCF physics definition with soft contact models
    [mico.xml]
2026-11-10 feat(sim): implement MuJoCo interactive visualizer and camera FPV streaming
2026-11-10 feat(sim): implement dynamic balance controller and ground reaction force monitoring
2026-11-11 feat(ai): design hardware-faithful 60-dim observation space matching physical BOM
2026-11-12 feat(benchmark): implement autonomous 20 Hz closed-loop locomotion node
2026-11-12 feat(autonomy): implement Radxa Zero 3W NPU camera subscriber ROS 2 node
2026-11-12 docs(mechanical): author leg v3 kinematic design and engineering specifications
2026-11-12 docs(mechanical): author 2D dimensioned engineering drawings for leg and foot brackets
2026-11-12 docs(mechanical): compile photographic assembly sequence for 6-DOF bipedal legs
2026-11-12 docs(mechanical): author v4 robot architecture assembly guide and exploded view steps
2026-11-12 docs(engineering): compile engineering benchmarks, torque margins and electrical schematic documentation
    [bom_aplus.csv]
2026-11-13 feat(hardware): relocate MPU9250 to head_pitch_link and implement 5 perception mitigations
    [humanoid.urdf, mico.urdf.xacro, mico.xml]
2026-11-13 feat(identity): complete end-to-end migration from Mico to Bazan architecture and tooling
    [base__cyan.stl, base__grey.stl, base__joint.stl, base__orange.stl, base__red.stl, base__visor.stl, base__white.stl, base__yellow.stl]
2026-11-13 feat(mechanical): add Bazan shell v1 (chest/back clamshell, helmet, visor) on the 16 shell inserts
    BazanShell builds 5 FDM parts (1.2 mm walls, 0.4 mm seam gap) fastened only with M2x6
    into the frame's existing inserts, checks them against robot.assemble() at the zero pose
    and over robot.sweep_poses (0 collisions, full sweep) and exports out/shell_*.step/.stl.
    [shell.py]
